aleperno/labotpfinal/README.md

labotpfinal
===========

Archivos para el proyecto final de la materia Laboratorio (66.01) de la Facultad de Ingenieria (UBA)
