aleperno/labotpfinal/informe.pdf

## U.B.A. FACULTAD DE INGENIERÍA

## Departamento de Electrónica

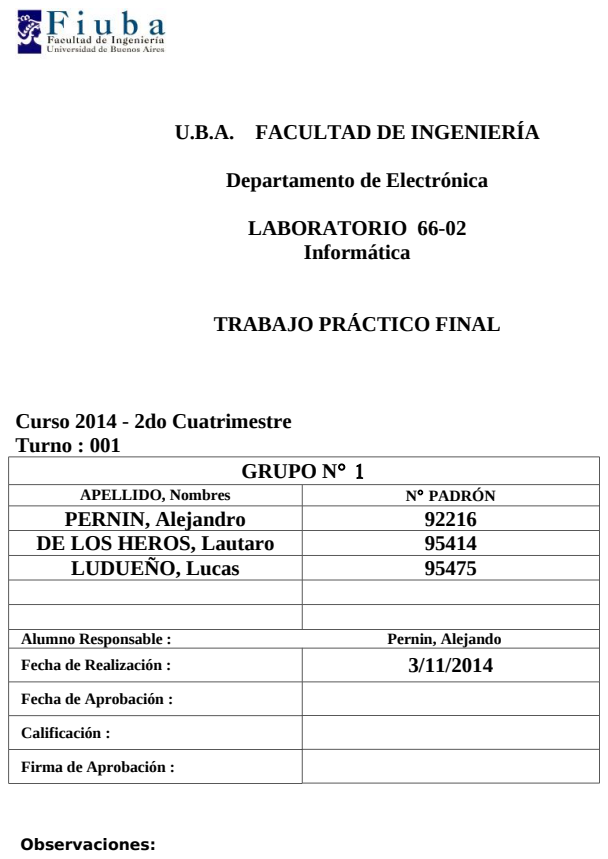
[picture p19: page 1]
LABORATORIO 66-02 Informática; Curso 2014 - 2do Cuatrimestre Turno : 001; GRUPO N° 1; APELLIDO, Nombres; N° PADRÓN; PERNIN, Alejandro; DE LOS HEROS, Lautaro; LUDUEÑO, Lucas; Alumno Responsable :; Pernin, Alejando; Fecha de Realización :; Calificación :; Observaciones:

TRABAJO PRÁCTICO FINAL

Fecha de Aprobación :

Firma de Aprobación :

# TP Final

### Grupo 1

### 20 de noviembre de 2014

Facultad de Ingenieria | Laboratorio - 66.02 - Curso 001 - TP Final

## Índice

1. Introducción | 4
2. Circuito Esquemático | 5
3. Diagrama de bloques | 5
4. Desarrollo | 6
5. Escalabilidad | 16
6. Referencias | 18

## 1. Introducción

El objetivo de este informe es exponer el trabajo práctico final, mostrando los desarrollos, mediciones efectuadas, funcionamiento y decisiones tomadas durante la confección del mismo. Este fue realizado a lo largo del cuatrimestre en paralelo con las clases prácticas y los ´ otros trabajos prácticos. Todos los archivo aquí utilizados, incluyendo este informe y su fuente estarán disponibles en http://github.com/aleperno/labotpfinal. Adicionalmente habrán disponibles algunos videos en YouTube con filmaciones de determinadas mediciones, por lo que es recomendable tener este informe en formato digital para fácil acceso a dichos links.

### 1.1. Opciones Disponibles

Habiendo diversas alternativas de proyectos de TPs para elegir, en un principio no estuvo del todo claro cuál elegir ya que todos tenian sus complicaciones y objetivos. Algunas de las alternativas disponibles eran la confección de una fuente, un sensor, etc.

### 1.2. Opción Elegida

Como proyecto base decidimos desarrollar un voltímetro vúmetro disponible en los cursos de CEKIT 1
. Elegimos este proyecto ya que si bien se trata de un proyecto relativamente sencillo, tiene aplicaciones reales tanto industriales como hogareñas.
Además aprovechando que uno de los integrantes poseía un Arduino 2 y una Raspberry 3 decidimos como opcional escalar el proyecto utilizando dichos elementos. En el informe se desarrollará el proyecto base y el opcional se detallará en la sección 5 de escalabilidad del proyecto.
El vúmetro consiste en un arreglo de LEDs que se van encendiendo conforme aumenta la tensión mensurada, la relación entre la cantidad de LEDs encendidos y la tensión proviene de las características intrínsecas del circuito cuyo análisis es parte de este informe. En este proyecto no sólo se implementan las nociones aprendidas tanto en las clases teóricas como en los TPs realizados, sino que además se emplearon nociones de diseño y elaboración de circuitos y software; por lo que es válido decir que este es un proyecto integrador.

1Pdf del proyecto oringal https://github.com/aleperno/labotpfinal/raw/master/cekit.pdf2http://arduino.cc/
3http://www.raspberrypi.org/

## 2. Circuito Esquemático

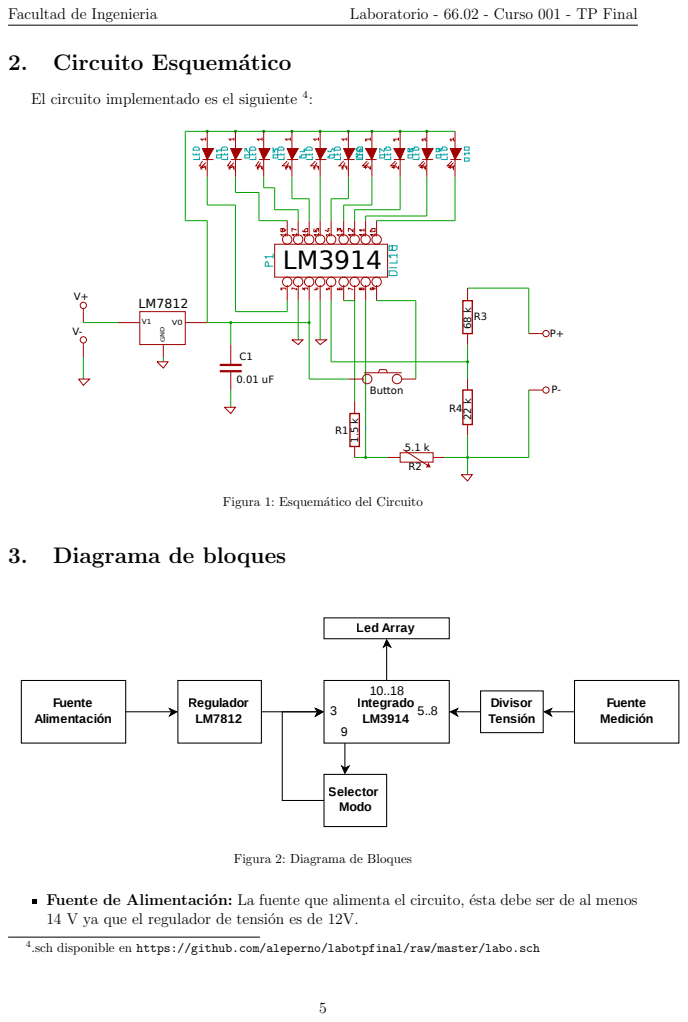
[picture p20: page 5]
GND; Button; Fuente Alimentación; Regulador LM7812; Integrado LM3914 3; Selector Modo; Fuente Medición; Divisor Tensión; Led Array

El circuito implementado es el siguiente 4

Figura 1: Esquemático del Circuito

3. Diagrama de bloques

Figura 2: Diagrama de Bloques

Fuente de Alimentación: La fuente que alimenta el circuito, ésta debe ser de al menos
14 V ya que el regulador de tensión es de 12V.

.sch disponible en https://github.com/aleperno/labotpfinal/raw/master/labo.sch

Regulador de Tensión: El regulador cumple la función de mantener el equipo alimen-tado con 12 V, evitando daños si la entrada es mayor.

Selector Modo: Nos permite seleccionar ambos modos de funcionamiento del circuito, tanto en ”DOT”(se prende un sólo LED), como ”BAR”(Se prende consecutivamente el array).

Fuente Medición: Es la fuente de tensión a mensurar.

Divisor de Tensión: Siendo que el integrado posee un límite de 5 V de entrada a medir, se coloca un divisor de tensión para ajustar la tensión a las especificaciones.

Array de LEDs: Es el arreglo de LEDs luminosos en si, en este caso consiste de 10 LEDs.

Integrado LM3914: Es el integrado encargado de la lógica del circuito.

## 4. Desarrollo

Como primera instancia se debió analizar cuales serían los alcances del proyecto y ajustar las características del circuito al mismo. Lo principal a definir fue el rango de tensiones que mediriámos, decidimos utilizar el mismo rango utilizado como ejemplo en el proyecto orignal, comprendido entre los 0 y 25 V.
Acorde al datasheet del integrado 5
el resistor R1 es el encargado de regular la luminosidad de los LED. Asimismo se establece como corrientes de salida hacia los LED de un mínimo de 7 mA y un típico de 10 mA, para el proyecto establecimos un valor intermedio en 8,3 mA. Siendo la tensión interna de referencia de 1,25 V, por la ley de Ohm podemos calcular

R1 =

1,25 V ∗ 10 LED
8,3 mA
∼= 1,5 kΩ | (1)

Luego es preciso establecer un fondo de escala, la misma se calcula acorde la siguiente fórmula:

Vref = 1,25 V (1 + R2
R1
) | (2)

Siendo la máxima señal de entrada permitida de 5 V, para poder mensurar el rango antes mencionado (0 - 25 V) debemos emplear un divisor de tensión, para tal propósito se emplearon los resistores R3 = 68 kΩ y R4 = 22 kΩ. Acorde a estos valores, aplicando una tensión de 25 V, sobre R4 se obtendrá una caída de tensión equivalente a

∆VR4 =

25 V ∗ 22 kΩ
90 kΩ
∼= 6,1 V | (3)

Si consideramos la tensión máxima de referencia, según la ecuacion 2:

R2 =

Vref
1,25 V

− 1

∗ R1
Vref =5 V
= 4,5 kΩ | (4)

Siendo este resistor de un valor no comercial y con el fin de a posteriori poder realizar ajustes, empleamos un resistor variable de 10 kΩ. Teniendo todos los elementos principales ya descriptos, se prosiguió al diseño y confección del circuito.

5Ver sección 6.

### 4.1. Construcción

Como primer instancia luego de adquirir todos los elementos, se armó el circuito en un protoboard a fin de corroborar el funcionamiento de todos los componentes individual y con-juntamente.

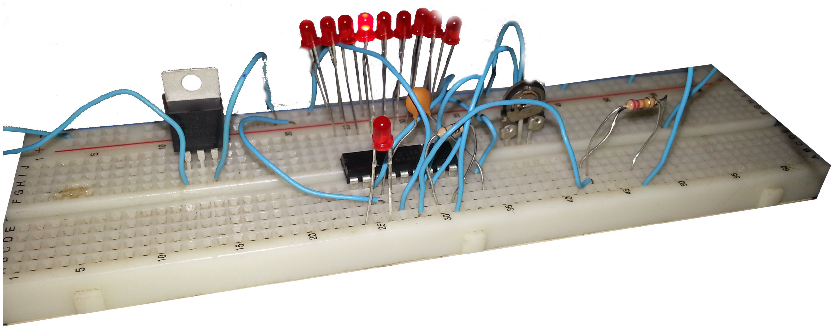
[picture p21: figure]

Figura 3: Prototipo modo DOT

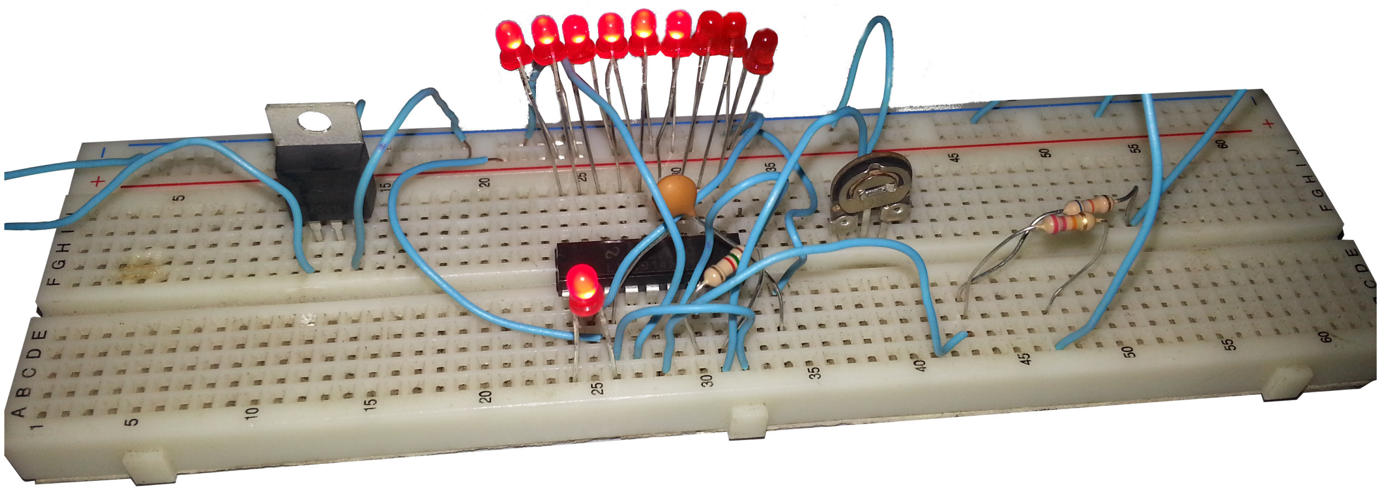
[picture p22: figure]

Figura 4: Prototipo modo BAR

Luego aprovechando la disponibilidad de un archivo esquemático, utilizando herramientas informáticas se diseñó un circuito virtual que luego sería pasado a una plaqueta de cobre.

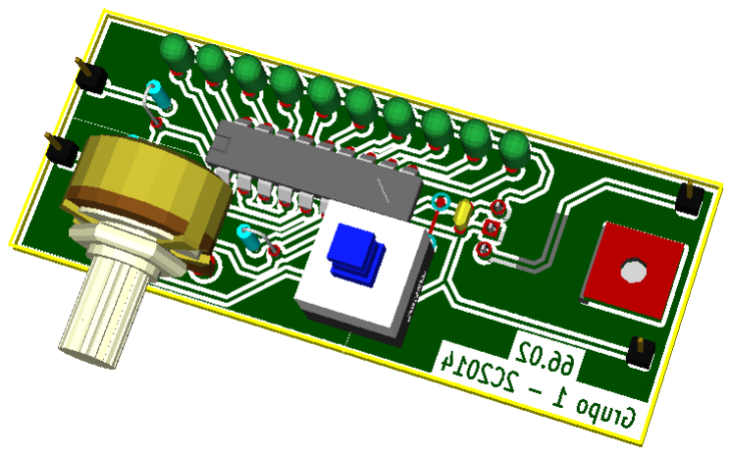
[picture p23: figure]

Figura 5: Vista Superior Circuito Virtual

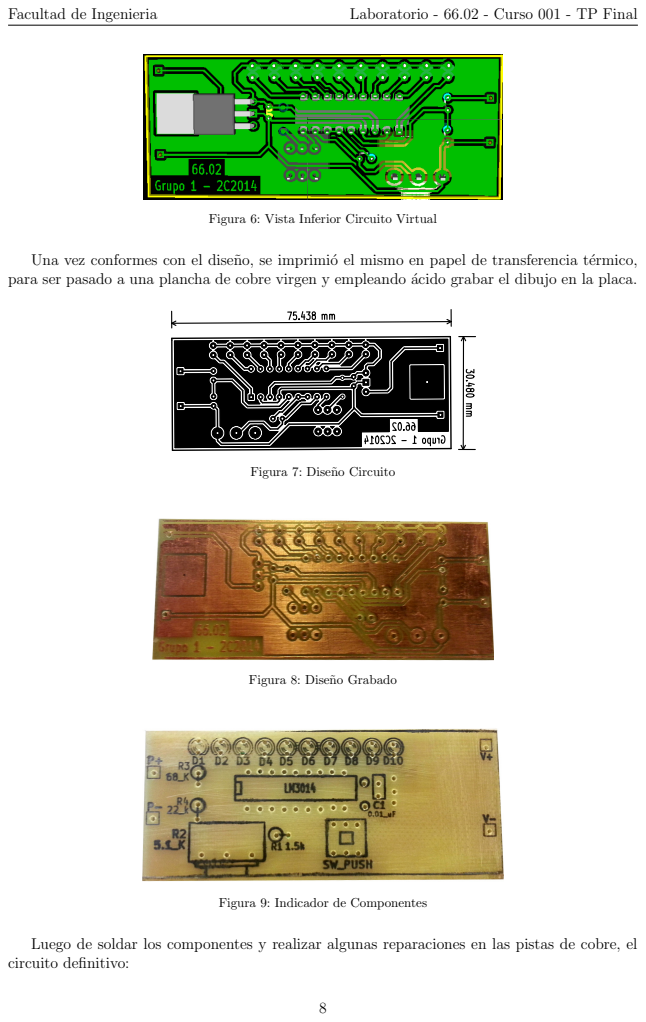
[picture p24: page 8]

Figura 6: Vista Inferior Circuito Virtual

Una vez conformes con el diseño, se imprimió el mismo en papel de transferencia térmico,
para ser pasado a una plancha de cobre virgen y empleando ácido grabar el dibujo en la placa.

Figura 7: Diseño Circuito

Figura 8: Diseño Grabado

Figura 9: Indicador de Componentes

Luego de soldar los componentes y realizar algunas reparaciones en las pistas de cobre, el
circuito definitivo:

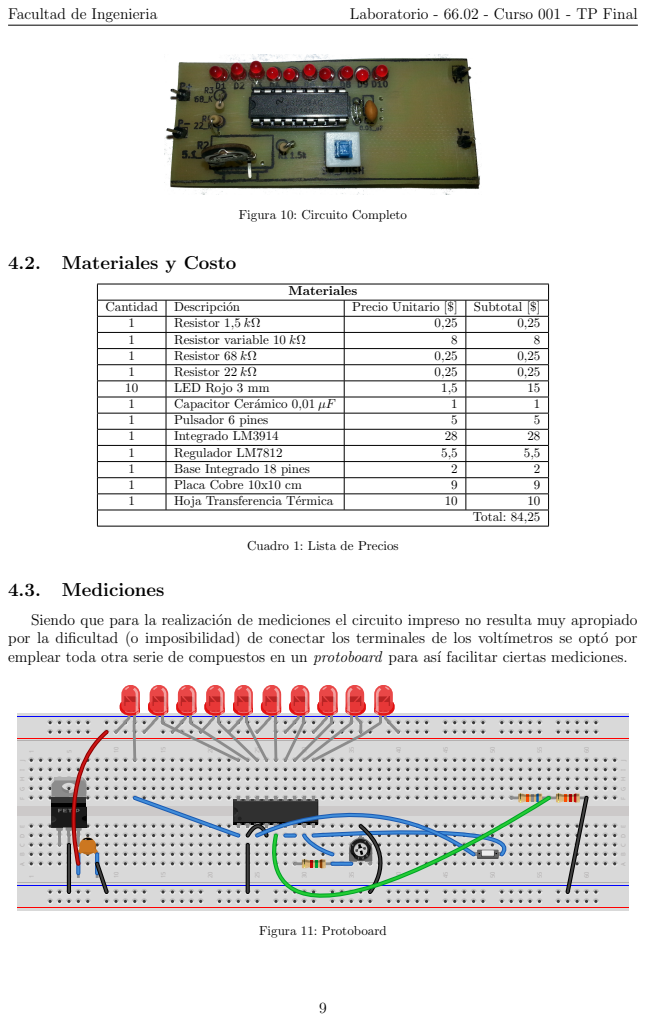
[picture p25: page 9]
4.2. Materiales y Costo; Materiales; Total: 84,25; 4.3. Mediciones; Figura 11: Protoboard

Figura 10: Circuito Completo

Cantidad | Descripción | Precio Unitario [$] | Subtotal [$]
1 | Resistor 1,5 kΩ | 0,25 | 0,25
1 | Resistor variable 10 kΩ | 8 | 8
1 | Resistor 68 kΩ | 0,25 | 0,25
1 | Resistor 22 kΩ | 0,25 | 0,25
10 | LED Rojo 3 mm | 1,5 | 15
1 | Capacitor Cerámico 0,01 µF | 1 | 1
1 | Pulsador 6 pines | 5 | 5
1 | Integrado LM3914 | 28 | 28
1 | Regulador LM7812 | 5,5 | 5,5
1 | Base Integrado 18 pines | 2 | 2
1 | Placa Cobre 10x10 cm | 9 | 9
1 | Hoja Transferencia Térmica | 10 | 10

Cuadro 1: Lista de Precios

Siendo que para la realización de mediciones el circuito impreso no resulta muy apropiado
por la dificultad (o imposibilidad) de conectar los terminales de los voltímetros se optó por
emplear toda otra serie de compuestos en un protoboard para así facilitar ciertas mediciones.

Para todas las mediciones a realizar se empleará el multímetro digital MS8221A utilizado en los trabajos anteriores, en caso de emplearse otro se aclarará explícitamente. Asímismo las fuentes reguladas a utilizar serán las HY3005D empleadas con anterioridad, para el funcionamiento de este proyecto se emplearán dos, una como alimentación del circuito y otra como fuente a mensurar.

### 4.3.1. Regulador

Uno de los componentes claves del circuito es el regulador de tensión LM7812, el cual se emplea con el propósito de obtener una salida constante de 12 V. Como primera medición se mide la salida del regulador respecto de la entrada de tensión. Se espera que a bajos voltajes la tensión de salida sea similar a la tensión de entrada pero menor. Además se espera que la tensión para la cual la salida se estabiliza, este uno o dos voltios por encima de los 12 V. Empleando un simple banco de medición con una fuente y un voltímetro se obtuvieron los

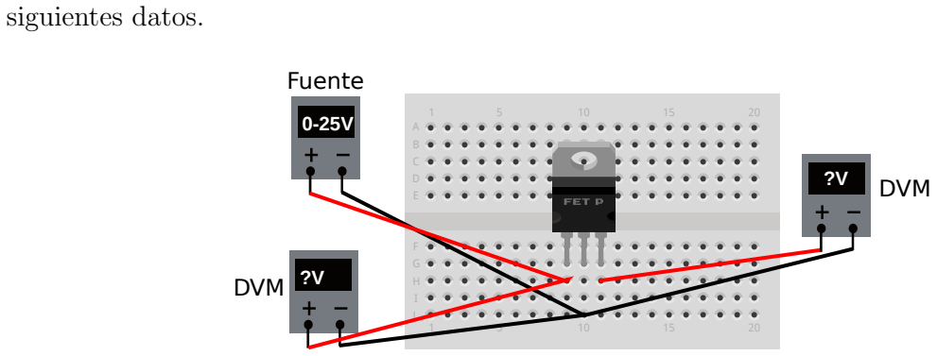
[picture p26: figure]
siguientes datos.; DVM; Fuente

Figura 12: Banco de Medición Regulador de Tensión

Regulador Tensión

Vin | ∆Vin | Vout | ∆Vout
1,62 | 0,02 | 0,97 | 0,02
3,24 | 0,03 | 2,55 | 0,02
4,96 | 0,04 | 4,2 | 0,04
7,56 | 0,05 | 6,75 | 0,05
10,34 | 0,07 | 9,5 | 0,05
12,44 | 0,08 | 11,58 | 0,07
12,76 | 0,08 | 11,91 | 0,07
13 | 0,08 | 12,14 | 0,08
13,13 | 0,08 | 12,2 | 0,08
13,37 | 0,08 | 12,21 | 0,08
14,36 | 0,09 | 12,21 | 0,08
15,75 | 0,09 | 12,21 | 0,08
17,38 | 0,10 | 12,22 | 0,08
20,1 | 0,3 | 12,21 | 0,08
22,4 | 0,3 | 12,21 | 0,08
24,5 | 0,3 | 12,21 | 0,08
28,1 | 0,3 | 12,22 | 0,08
31,4 | 0,3 | 12,25 | 0,08

Cuadro 2: Medición LM7812

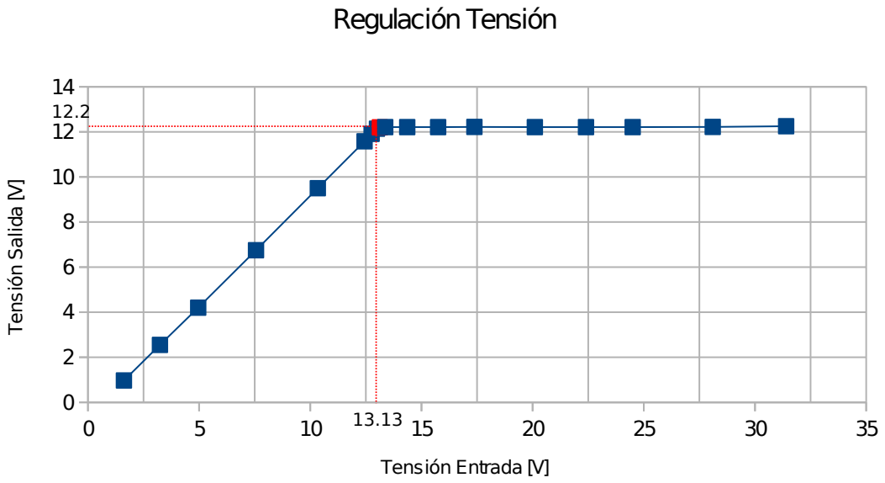
[picture p27: figure]
Regulación Tensión; Tensión Entrada [V]; Tensión Salida [V]

Figura 13: Tensión Salida Regulador

Como era de esperarse, la tensión de salida es lineal e inferior a la tensión de entrada a tensiones bajas. También confirmamos que el punto en el cuál la tensión de salida se estabiliza (13.13 V) se encuentra por encima de la tensión de regulación. La figura ?? no posee barras de errores ya que como se puede apreciar en el cuadro 2 los errores son despreciables respectos de los valores que operamos.

### 4.3.2. Escala

Acorde a las hipótesis realizadas, el vúmero posee un fondo de escala de 25 V distribuidos en 10 LEDs, por lo que cada LED representará un aumento en la tensión de 2,5 V.

Escala LEDs
#Led Encendido(s) | Tensión [V]

0 | < 2,5
1 | 2,5
2 | 5
3 | 7,5
4 | 10
5 | 12,5
6 | 15
7 | 17,5
8 | 20
9 | 22,5
10 | 25

Cuadro 3: Escala leds

Para corrobororar esta escala y/o realizar los ajustes necesarios se emplearon dos fuentes reguladas, una como fuente de alimentación del circuito y otra como fuente a mensurar. Asimismo en paralelo con la fuente a mensurar se coloca un multímetro digital a fin de tener una lectura mas exacta de la tensión respecto de la mostrada por la pantalla LED de la fuente.

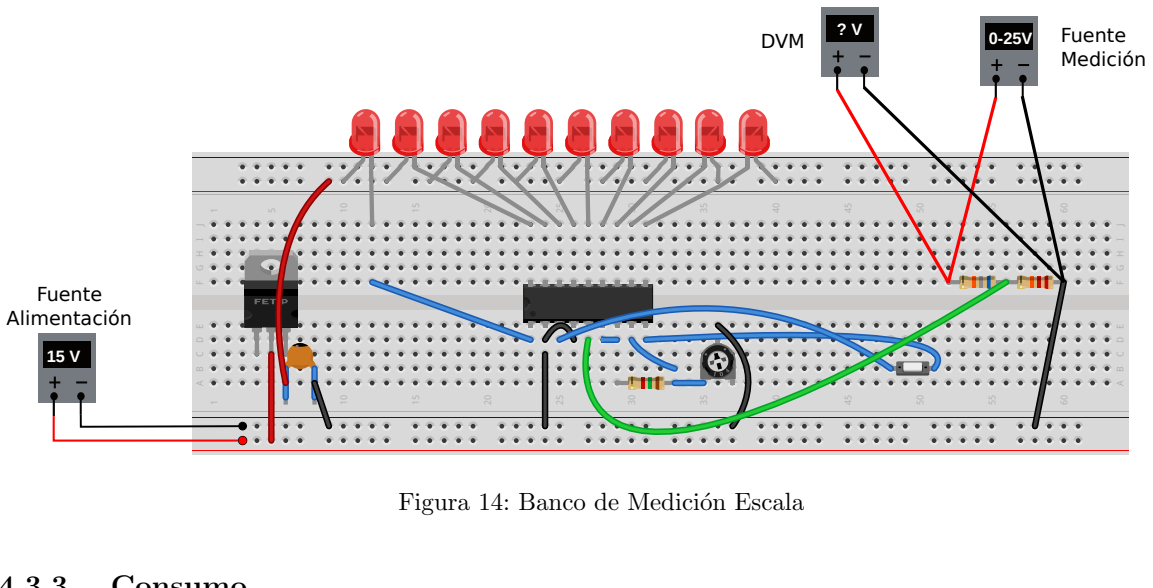
[picture p28: figure]
Fuente Alimentación; Fuente; Medición; ? V DVM; Figura 14: Banco de Medición Escala

### 4.3.3. Consumo

Una de las principales características de este circuito, es la capacidad de cambiar entre modo BAR y modo DOT, obteniendo así una misma lectura expresada en un sólo led o en un continuo de leds. A priori se puede deducir que entre ambos modos habrá una diferencia de consumo proveniente de tener un sólo led o un número de leds. Asímismo se espera que en modo punto el consumo sea lineal, para ello se fue variando la tensión de la fuente a mensurar y se midió la corriente. Con dichos valores se calculó la potencia.

Mediciones DOT
Tensión [V] | ∆V [V] | Corriente [mA] | ∆I [mA] | Consumo [mW] | ∆ Consumo [mW]
0,40 | 0,02 | 10,2 | 0,3 | 4,1 | 0,3
1,29 | 0,02 | 10,2 | 0,3 | 13,2 | 0,5
2,50 | 0,03 | 24,3 | 0,4 | 60,8 | 1,6
3,82 | 0,03 | 24,4 | 0,4 | 93,2 | 2,3
5,08 | 0,04 | 24,3 | 0,4 | 123,4 | 2,9
6,78 | 0,05 | 24,3 | 0,4 | 164,8 | 3,8
7,50 | 0,05 | 23,7 | 0,4 | 177,8 | 4,1
8,85 | 0,06 | 23,8 | 0,4 | 210,6 | 4,8
10,61 | 0,07 | 24,5 | 0,4 | 259,9 | 5,8
11,83 | 0,07 | 24,4 | 0,4 | 288,7 | 6,4
12,64 | 0,08 | 24,4 | 0,4 | 308,4 | 6,8
13,81 | 0,08 | 24,4 | 0,4 | 337,0 | 7,4
15,08 | 0,09 | 24,1 | 0,4 | 363,4 | 8,0
16,75 | 0,1 | 24,1 | 0,4 | 403,7 | 8,8
17,63 | 0,1 | 24,0 | 0,4 | 423,1 | 9,2
18,75 | 0,1 | 24,0 | 0,4 | 450,0 | 9,8
20,0 | 0,2 | 23,7 | 0,4 | 474,0 | 10,3
21,3 | 0,2 | 23,7 | 0,4 | 504,8 | 11,0
22,5 | 0,2 | 23,9 | 0,4 | 537,8 | 11,7
23,7 | 0,2 | 23,9 | 0,4 | 566,4 | 12,3
25,0 | 0,2 | 24,0 | 0,4 | 600,0 | 13,0
26,4 | 0,2 | 24,0 | 0,4 | 633,6 | 13,7

Cuadro 4: Medición Consumo modo DOT

Mediciones BAR
Tensión [V] | ∆V [V] | Corriente [mA] | ∆I [mA] | Consumo [mW] | ∆ Consumo [mW]
0,40 | 0,02 | 10,3 | 0,3 | 4,1 | 0,3
1,29 | 0,02 | 10,3 | 0,3 | 13,3 | 0,5
2,50 | 0,03 | 24,5 | 0,4 | 61,3 | 1,6
3,82 | 0,03 | 24,5 | 0,4 | 93,6 | 2,3
5,08 | 0,04 | 38,5 | 0,6 | 195,6 | 4,3
6,78 | 0,05 | 38,5 | 0,6 | 261,0 | 5,6
7,50 | 0,05 | 51,8 | 0,8 | 388,5 | 7,9
8,85 | 0,06 | 51,8 | 0,8 | 458,4 | 9,2
10,61 | 0,07 | 65,7 | 0,9 | 697,1 | 13,6
11,83 | 0,07 | 65,7 | 0,9 | 777,2 | 15,1
12,64 | 0,08 | 79,6 | 1,1 | 1006,1 | 19,2
13,81 | 0,08 | 79,6 | 1,1 | 1099,3 | 20,9
15,08 | 0,09 | 93,4 | 1,3 | 1408,5 | 26,4
16,75 | 0,1 | 93,4 | 1,3 | 1564,5 | 29,3
17,63 | 0,1 | 107,3 | 1,4 | 1891,7 | 35,0
18,75 | 0,1 | 107,3 | 1,4 | 2011,9 | 37,2
20,0 | 0,2 | 120,4 | 1,6 | 2408,0 | 44,2
21,3 | 0,2 | 120,5 | 1,6 | 2566,7 | 47,0
22,5 | 0,2 | 133,0 | 1,7 | 2992,5 | 54,5
23,7 | 0,2 | 133,1 | 1,7 | 3154,5 | 57,4
25,0 | 0,2 | 145,0 | 1,9 | 3625,0 | 65,6
26,4 | 0,2 | 145,2 | 1,9 | 3833,3 | 69,3

Cuadro 5: Medición Consumo modo BAR

Con toda esta información disponible, es posile comparar mediante gráficos y confirmar algunas deducciones.

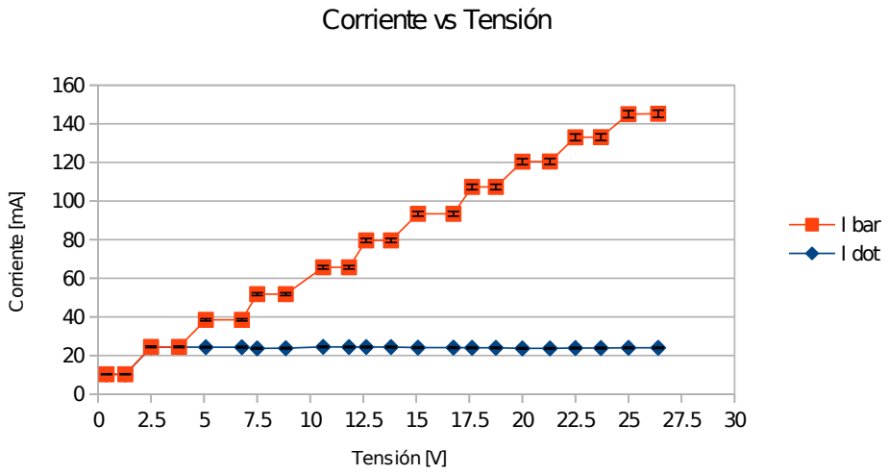
[picture p29: figure]
Corriente vs Tensión; I bar I dot; Tensión [V]; Corriente [mA]

0 | 2.5 | 5 | 7.5 10 12.5 15 17.5 20 22.5 25 27.5 30

Figura 15: Corriente vs Tensión

Como era de esperarse, la corriente en modo punto es constante observándose sólo un salto siendo que antes de los 2,5 V no se encuentra ningun led encendido. Asimismo se observa que en modo bar la corriente es lineal, habiendo unos descansos correspondientes a tensiones dentro del rango de un mismo led.
Una interrogante que se puede desprender de este gráfico es si dichos saltos son constantes.

### Salto Corriente

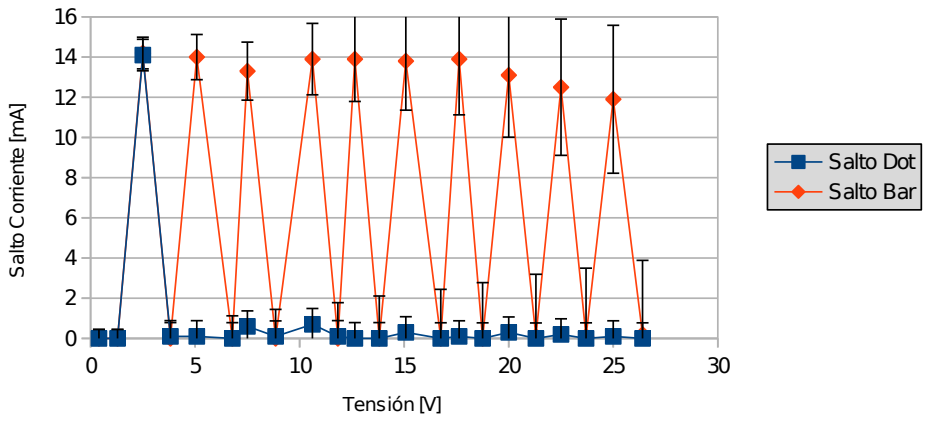
[picture p30: figure]
Salto Dot Salto Bar; Tensión [V]; Salto Corriente [mA]

Figura 16: Saltos Corriente

Estos saltos corresponden al valor de una corriente respecto de la corriente antes mensurada. Otra vez es observable como en modo punto sólo hay un salto y luego los saltos se encuentran muy próximos a 0. Para el modo bar, se observa una oscilacion correspondiente a que los puntos dentro del mismo rango de tension de un led (eg: 2,6 V y 3.0 V encienden el mismo led) no hay salto de corriente significativo, pero al encender un nuevo led si. Asimismo es visible como los valores pico de estos saltos se mantienen dentro de un rango discreto.

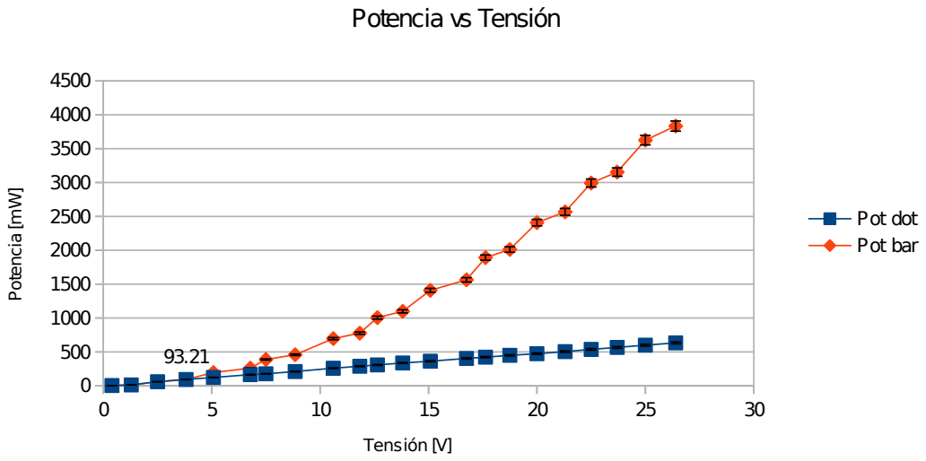
[picture p31: figure]
Potencia vs Tensión; Pot dot Pot bar; Tensión [V]; Potencia [mW]

Figura 17: Potencia

Es observable como la potencia disipada por el circuito en modo BAR no sólo es mayor al de modo DOT punto a punto, sino también como la curva de crecimiento de la misma tiene a una forma exponencial. Esto tiene sentido ya que considerando la potencia como

P = V ∗ I | (5)

donde P, V e I son la potencia, tensión y corriente respectivamente; de ser la corriente constante la potencia describirá una curva lineal tal cual indica la figura 17 para el modo DOT. En el caso del modo BAR, la corriente incrementa linealmente respecto de la tensión (ver figura 15) pudiéndola expresar como I = αV , siendo α una constante de proporción. Aplicando esto a la ecuación arriba descripta

P = V ∗ I = V ∗ αV = αV ²
(6)

lo que valida que la curva describa una trayectoria exponencial.

## 5. Escalabilidad

Pensando en las aplicaciones prácticas de un voltímetro, nos encontramos con la necesidad de poder obtener una lectura exacta y/o a distancia. Un vúmetro si bien es de lectura sencilla, no nos da un valor númerico ni tampoco nos permite leer la lectura a distancia. Si pensamos esto a nivel industrial es una gran desventaja, quizá por cuestiones de la complejidad de un determinado proceso es preciso obtener una lectura exacta; asimismo las extensiones de las plantas industriales obligan a realizar mediciones mediante sensores que reporten a una base central, para consultarlas en un centro de control.
Abstrayendonos del caso insdustrial planteado y aprovechando que un compañero poseía un Arduino y Raspberry, decidimos implementar un voltímetro que muestre en una pantalla LED la tensión mensurada y asímismo permita una lectura a distancia. Para ello utilizamos un Arduino Mega 2560 R3 6

con un shield LCD DFRobot⁷ y una Raspberry Pi B+ 8 .
En nuestro caso el Arduino actuará como sensor, que no sólo tomará las mediciones sino que las mostrará en una pantalla LCD sino que también las comunicará a la Raspberry por puerto serie. La Raspberry representará un sistema central de obtención de mediciones, en la misma se instaló un servidor web Apache y una simple página en PHP que muestra vía web las tensiones mensuradas en tiempo real. Además esta configuración nos permitiría registrar un historial de las mediciones realizadas para posterior análisis.
Utilizando el mismo rango de tensiones utilizado con el vúmetro y siendo la máxima tensión permitida por el Arduino de 5 V es necesario utilizar un resistor de tensión, para lo cuál se utilizaron resistores de 100 Ω y 1 kΩ.

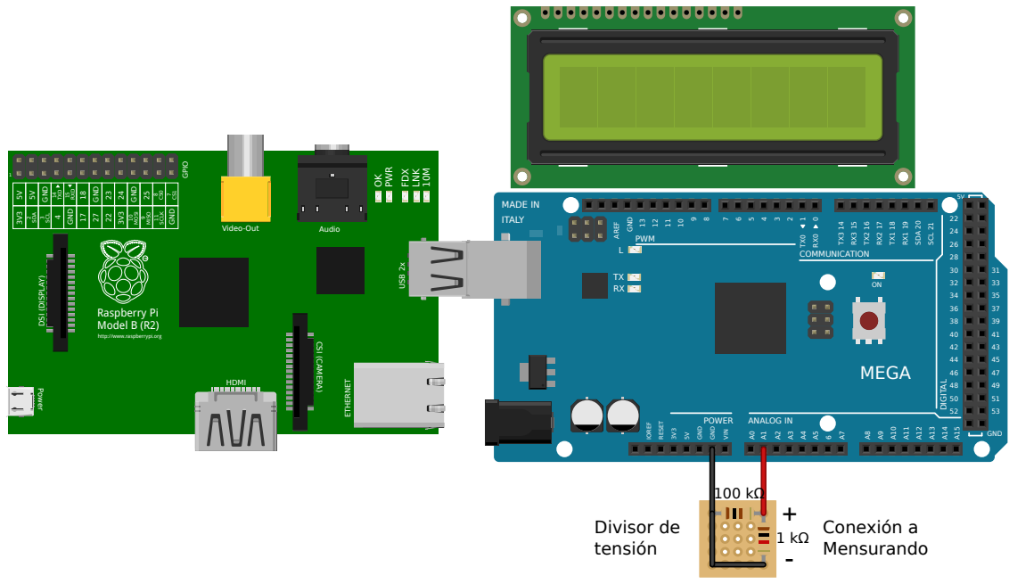
[picture p32: figure]
ANALOG IN; COMMUNICATION; POWER; AREF; GND; RESET; VIN; SDA 20; SCL 21; MADE IN; ITALY; PWM; DIGITAL; MEGA; IOREF; Raspberry Pi Model B (R2); http://www.raspberrypi.org; PWR; FDX; LNK; Power; HDMI; Video-Out; Audio; USB 2x; ETHERNET; DSI (DISPLAY); CSI (CAMERA); GPIO; 27 GND; MOSI; SDA; SCL; MISO; SCLK; TXD; RXD; + Conexión a; Mensurando; Divisor de; tensión

Figura 18: Banco Medición Arduino - Raspberry

Mediante un software compilado y cargado previamente, el Arduino mide la tensión aplicada al puerto analógico indicado (en este caso A1), calcula la tensión de la fuente mensurada

6http://arduino.cc/en/Main/arduinoBoardMega7http://www.dfrobot.com/wiki/index.php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 8http://www.raspberrypi.org/products/model-b-plus/

teniendo en cuenta las características del resistor de tensión e imprime en el LCD el valor además de transmitirlo por puerto serie (emulado por USB).

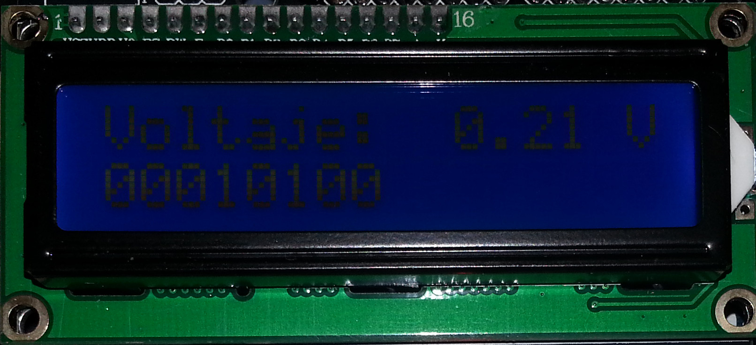
[picture p33: figure]

Figura 19: Prueba LCD

## 6. Referencias
