aleperno/labotpfinal/attachments/dvm_specs.pdf

### 3.2.1 DC VOLTAGE

Accuracy Range | Resolution | MS8221A/8221D | MS8221B/8230B
0.2V | 0.1mV | | ±0.5%±2
2V | 1mV | | ±0.5%±3
20V | 0.01V | | ±0.8%±3
200V | 0.1V
1000V | 1V | ±0.8%±2 | ±0.8%±5

±0.5%±1

- Input impedance: MS8221A/MS8221D: 10MΩ MS8221B/MS8230B: 1MΩ
- Max. input voltage: 200mV range: 250VDC or AC rms 2V - 1000V ranges: 1000VDC or 750V rms
