aleperno/labotpfinal/attachments/dvm_specs1.pdf

3.2.3 DC CURRENT
Accuracy Range | Resolution | MS8221A/8221D | MS8221B/8230B
200uA | 0.1uA | ±0.8%±1 | ±1.0%±2
2mA | 1 uA
20mA | 10 uA | | ±1.5%±2
200mA | 100uA | ±1.2%±1
10A | 10mA | ±2.0%±5 | ±3.0%±2
Overload protection: F250mA/250V fuse (10A range unfused).
Max. Input Current: mA Jack: 200mA, 10A Jack: 10A
