aleperno/labotpfinal/images/arduino7.pdf

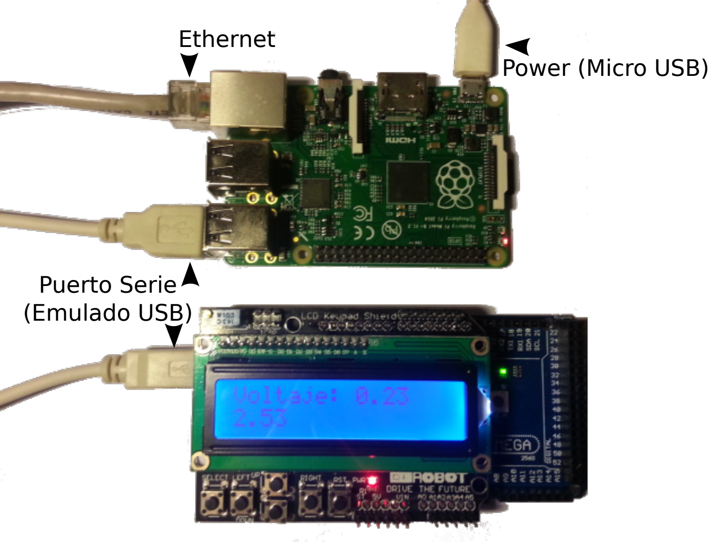
[picture p34: page 1]

Puerto Serie
(Emulado USB)

Ethernet
Power (Micro USB)
