aleperno/labotpfinal/images/bloque.pdf

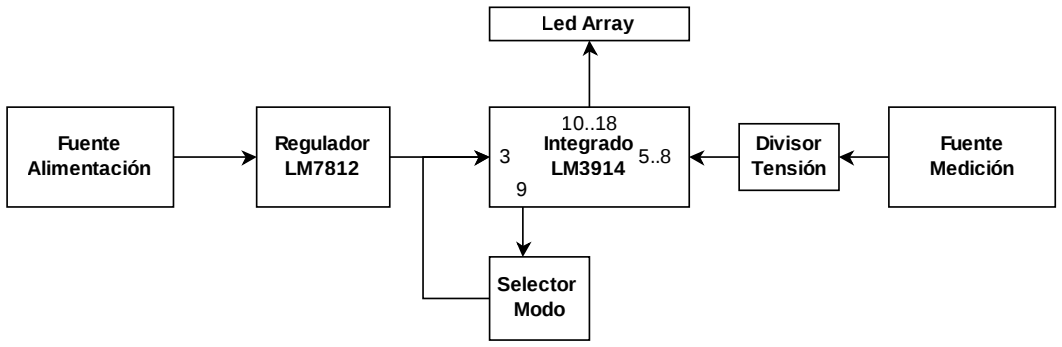
[picture p35: figure]
Fuente Alimentación; Regulador LM7812; Integrado LM3914 3; Selector Modo; Fuente Medición; Divisor Tensión; Led Array
