aleperno/labotpfinal/images/med_reg.pdf

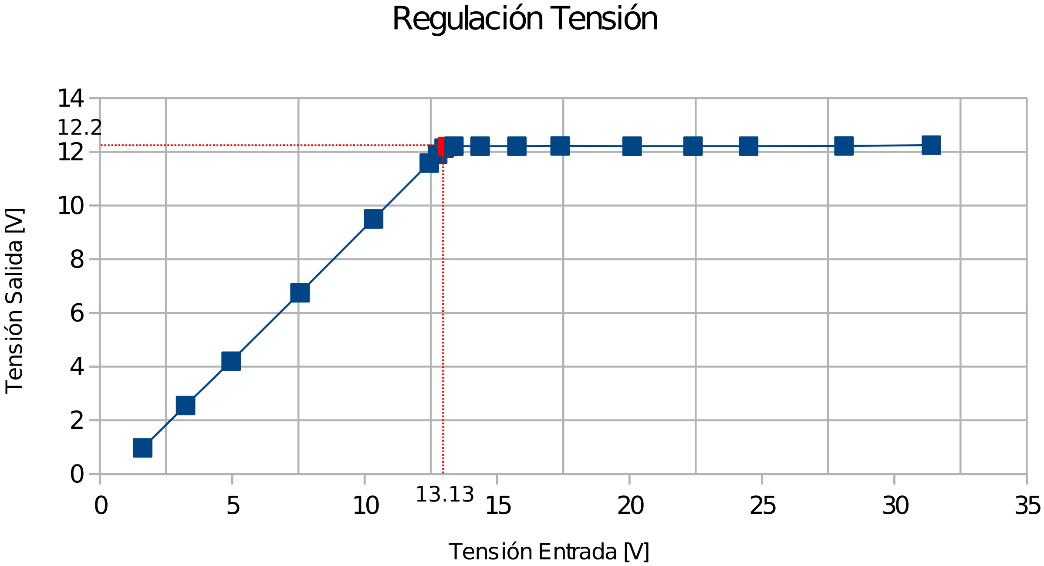
[picture p36: figure]
Regulación Tensión; Tensión Entrada [V]; Tensión Salida [V]
