aleperno/labotpfinal/images/salto.pdf

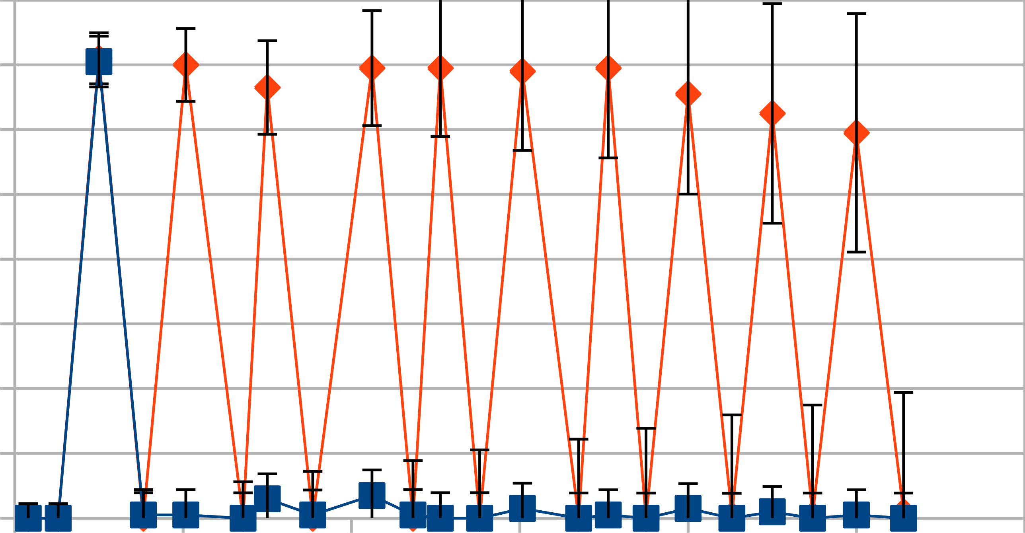
[picture p37: figure]

0 | 5 | 10 | 15 | 20 | 25 | 30

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
### Salto Corriente

Salto Dot
Salto Bar

Tensión [V]

Salto Corriente [mA]
