aleperno/labotpfinal/images/labo.png

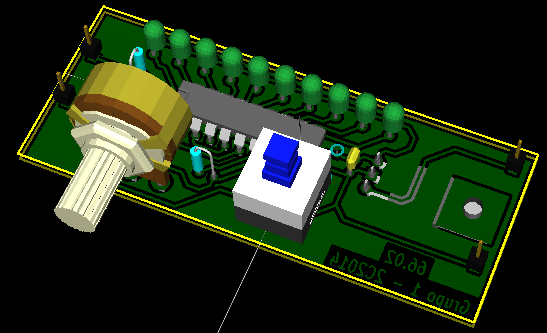
images/labo.png
