aleperno/labotpfinal/images/Cronograma.pdf

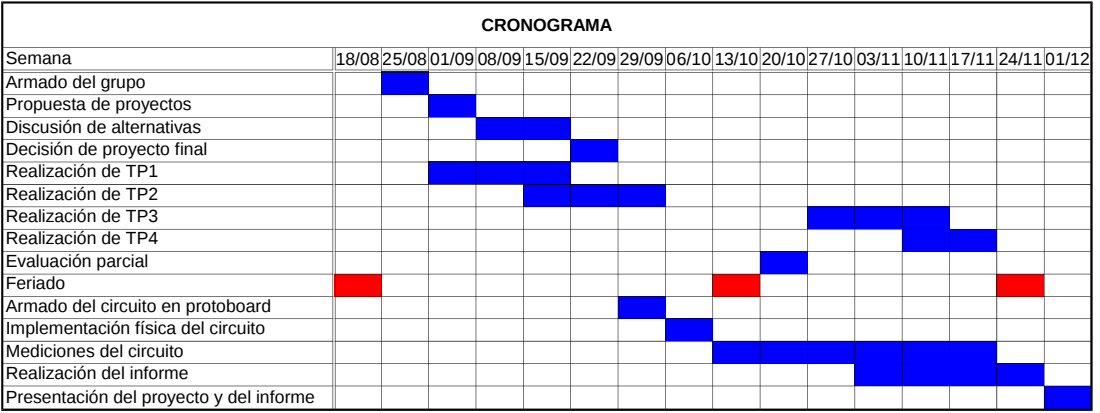
[picture p39: page 1]
CRONOGRAMA; Semana

Armado del grupo
Propuesta de proyectos
Discusión de alternativas
Decisión de proyecto final
Realización de TP1
Realización de TP2
Realización de TP3
Realización de TP4
Evaluación parcial
Feriado
Armado del circuito en protoboard
Implementación física del circuito
Mediciones del circuito
Realización del informe
Presentación del proyecto y del informe
