aleperno/labotpfinal/images/arduino3.pdf

### Lectura Arduino

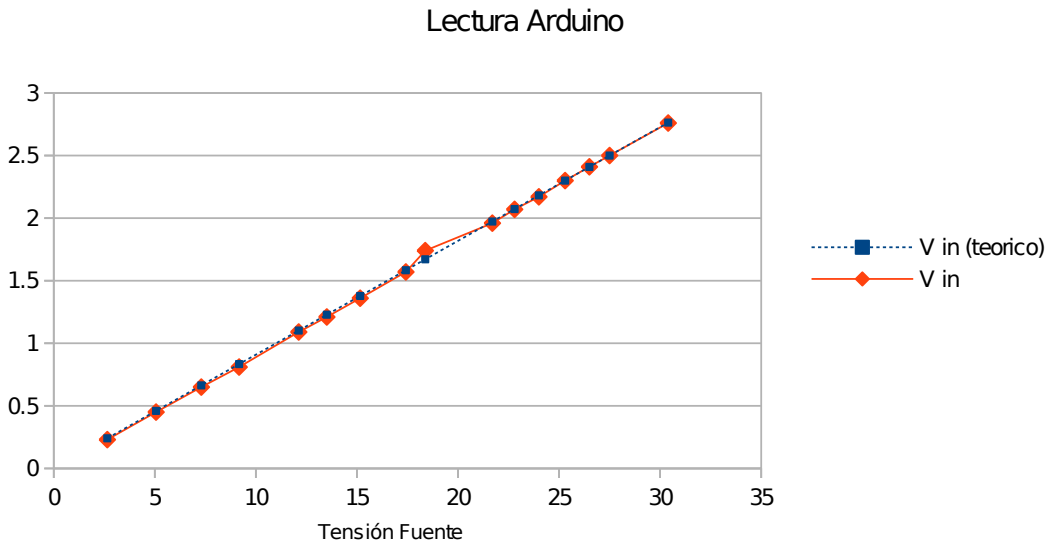
[picture p40: page 1]
V in (teorico) V in; Tensión Fuente
