aleperno/labotpfinal/images/reg.pdf

0-25V

# Fuente

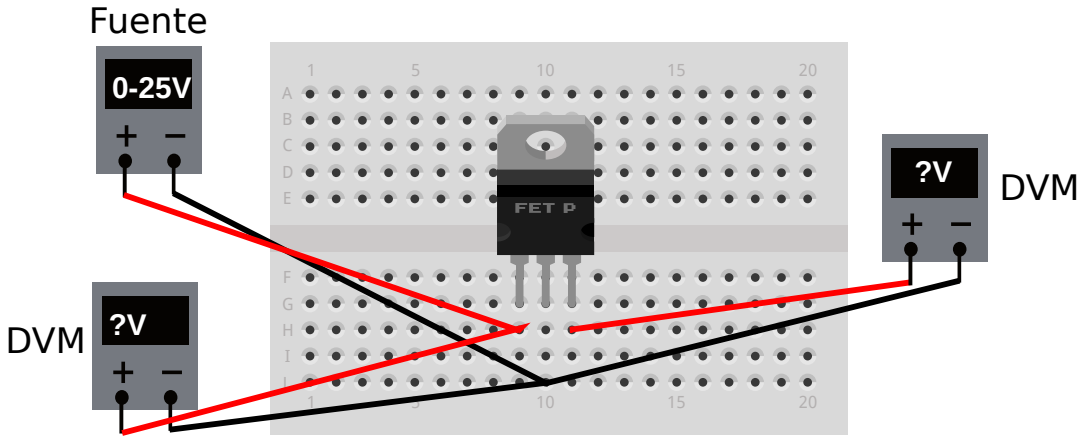
[picture p41: page 1]
ABCDEFGHIJ; DVM
