aleperno/labotpfinal/images/sch.pdf

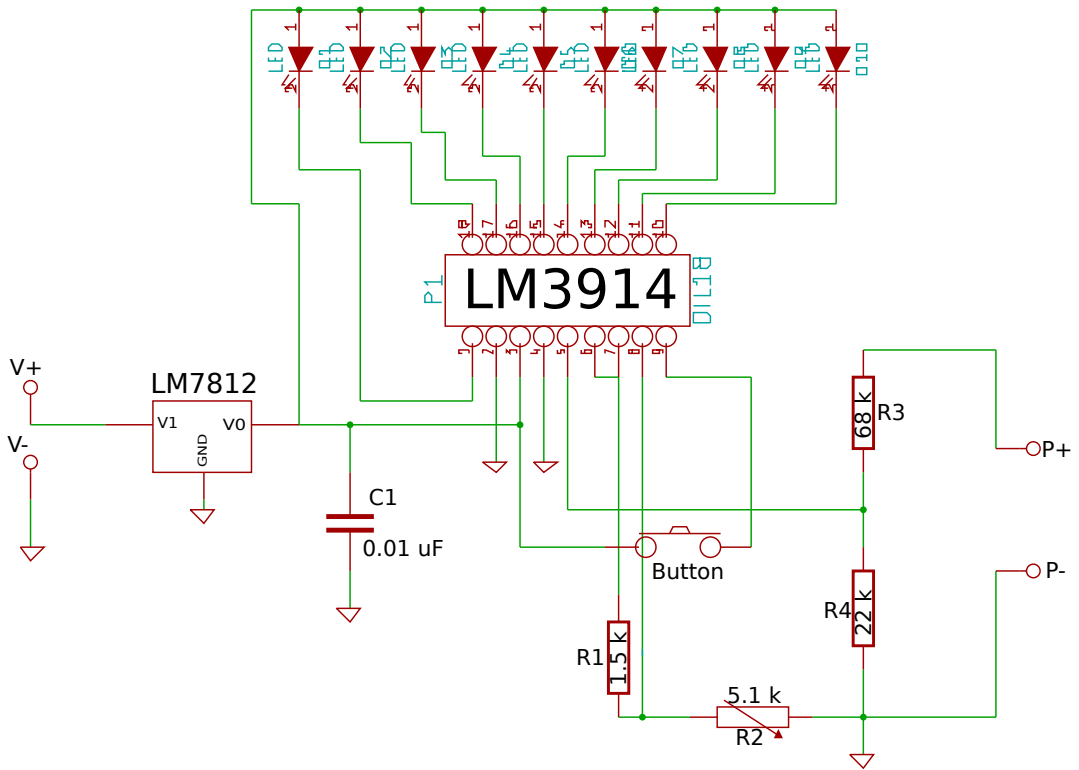
[picture p42: page 1]
GND; Button
