aleperno/labotpfinal/images/design.pdf

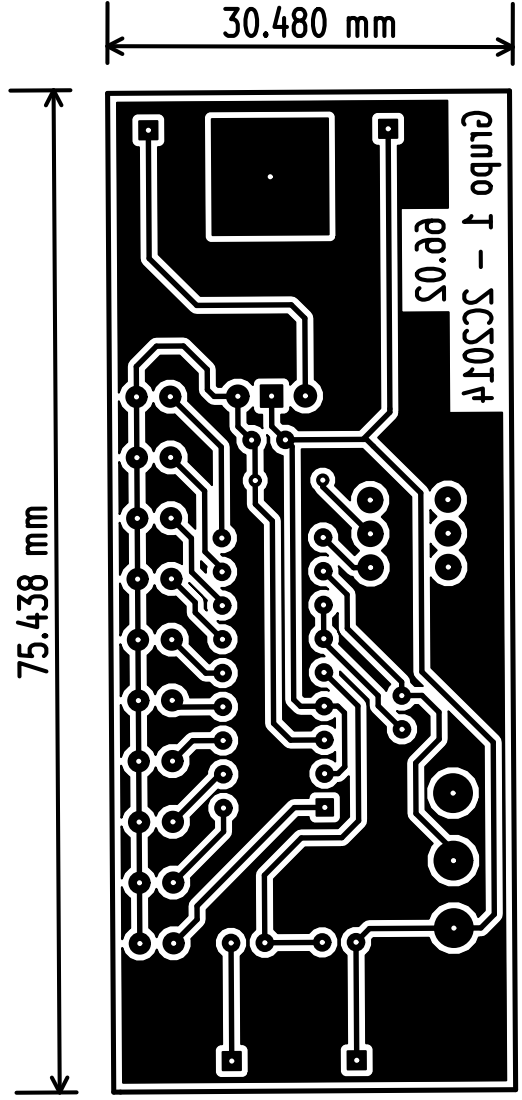
[picture p43: page 1]
