aleperno/labotpfinal/images/corriente.pdf

### Corriente vs Tensión

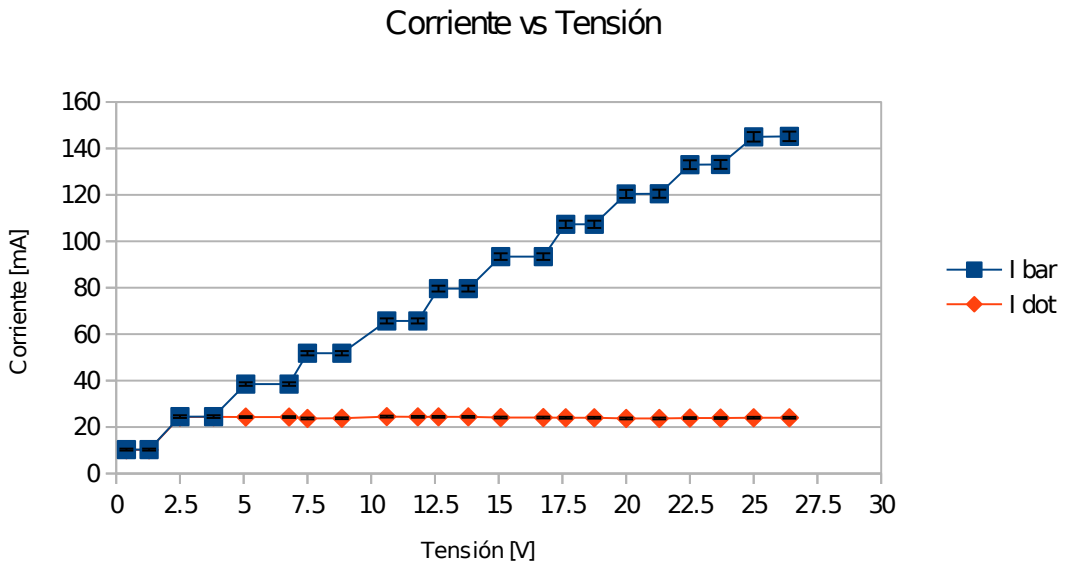
[picture p44: page 1]
I bar I dot; Tensión [V]; Corriente [mA]
