aleperno/labotpfinal/images/pot.pdf

### Potencia vs Tensión

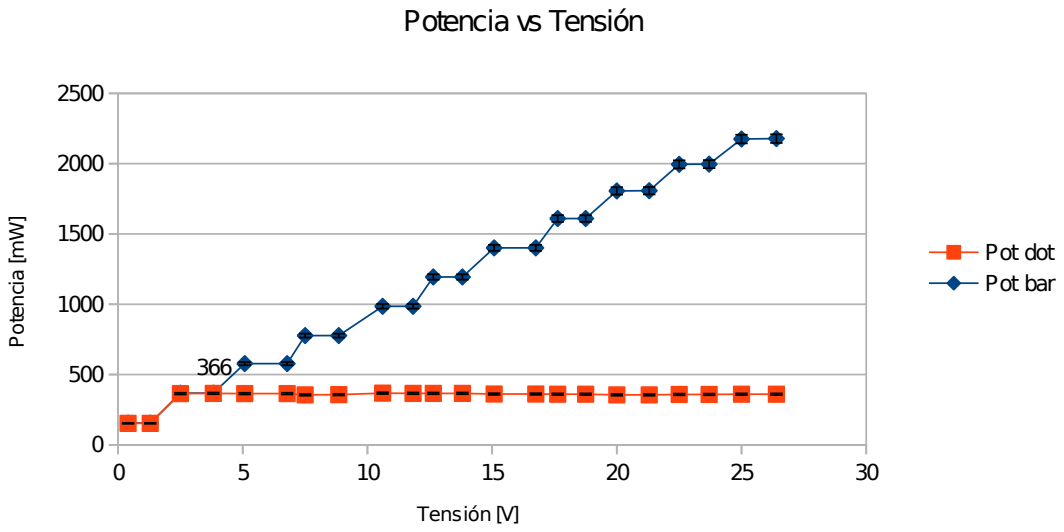
[picture p45: page 1]
Pot dot Pot bar; Tensión [V]; Potencia [mW]
