aleperno/labotpfinal/images/arduino4.pdf

### Diferencia Lectura vs Fuente

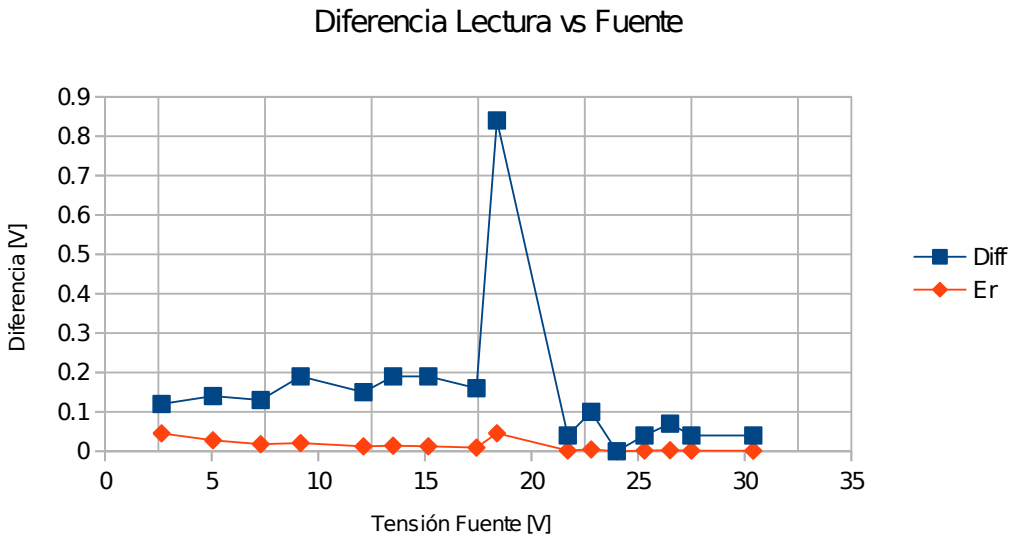
[picture p46: page 1]
Diff Er; Tensión Fuente [V]; Diferencia [V]
