aleperno/labotpfinal/images/div.pdf

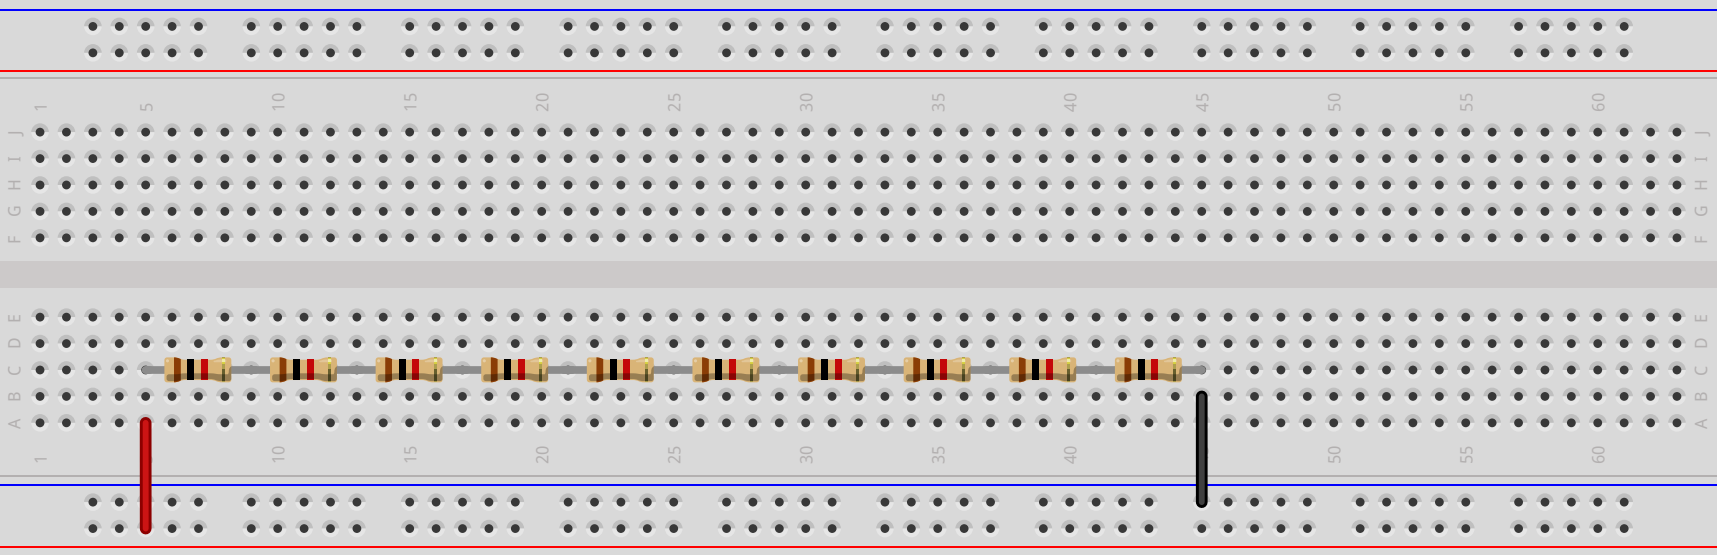
[picture p47: page 1]
