aleperno/labotpfinal/images/labo1_bb.pdf

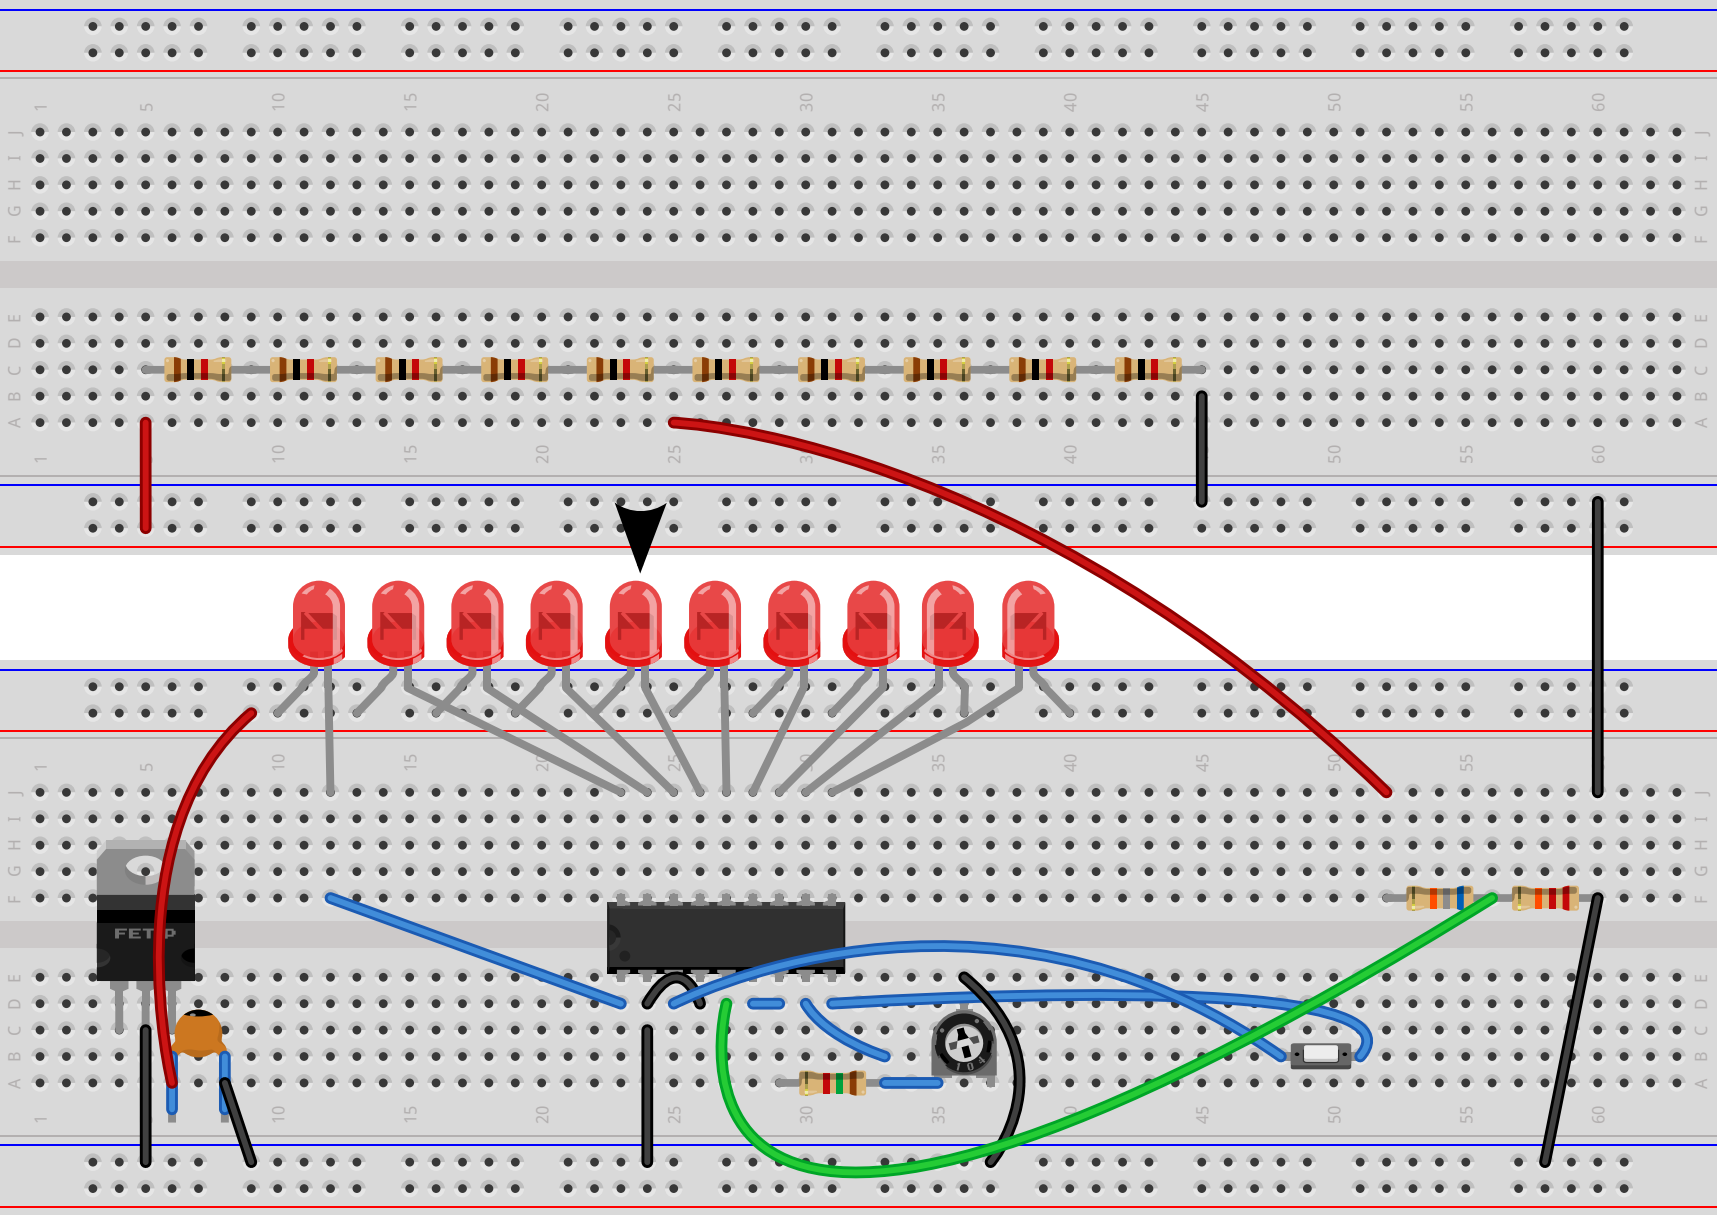
[picture p48: page 1]
