aleperno/labotpfinal/images/labo1_bb1.pdf

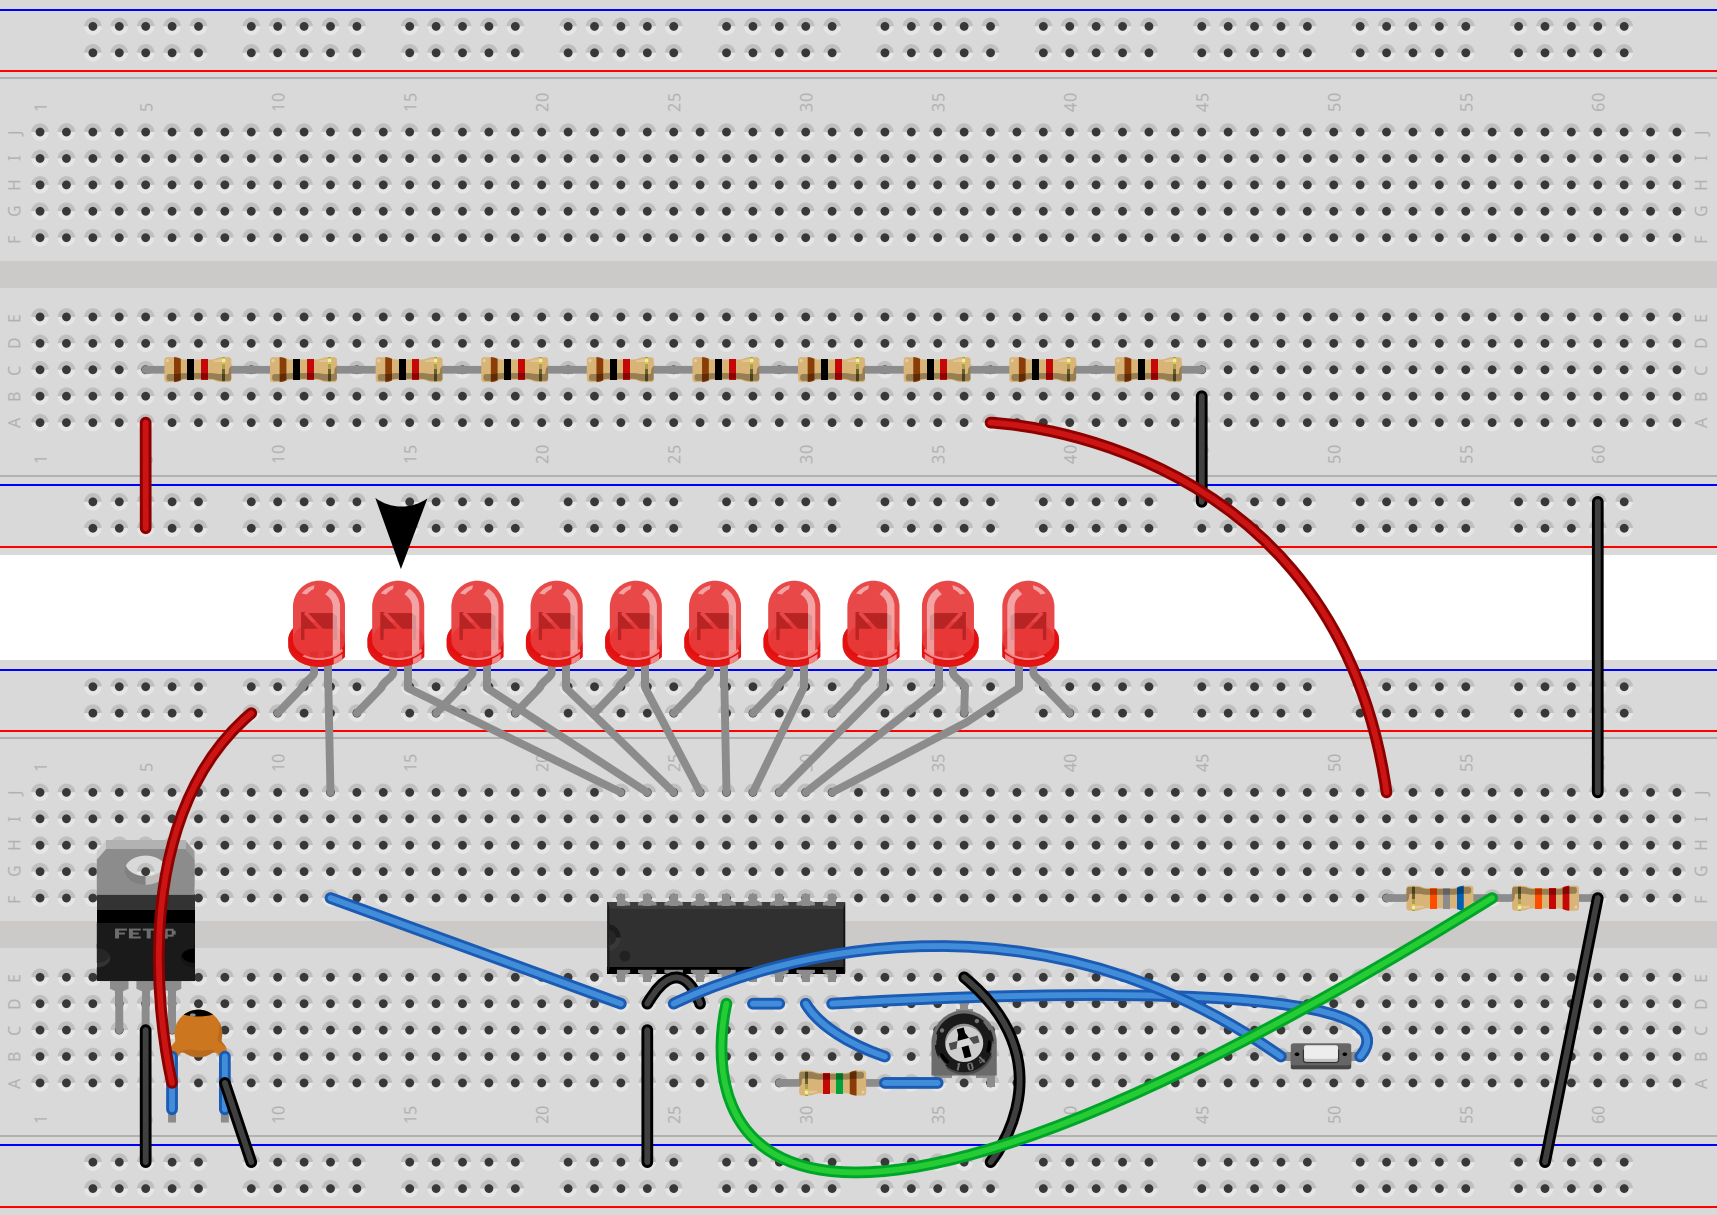
[picture p49: page 1]
