aleperno/labotpfinal/images/labo1_bb2.pdf

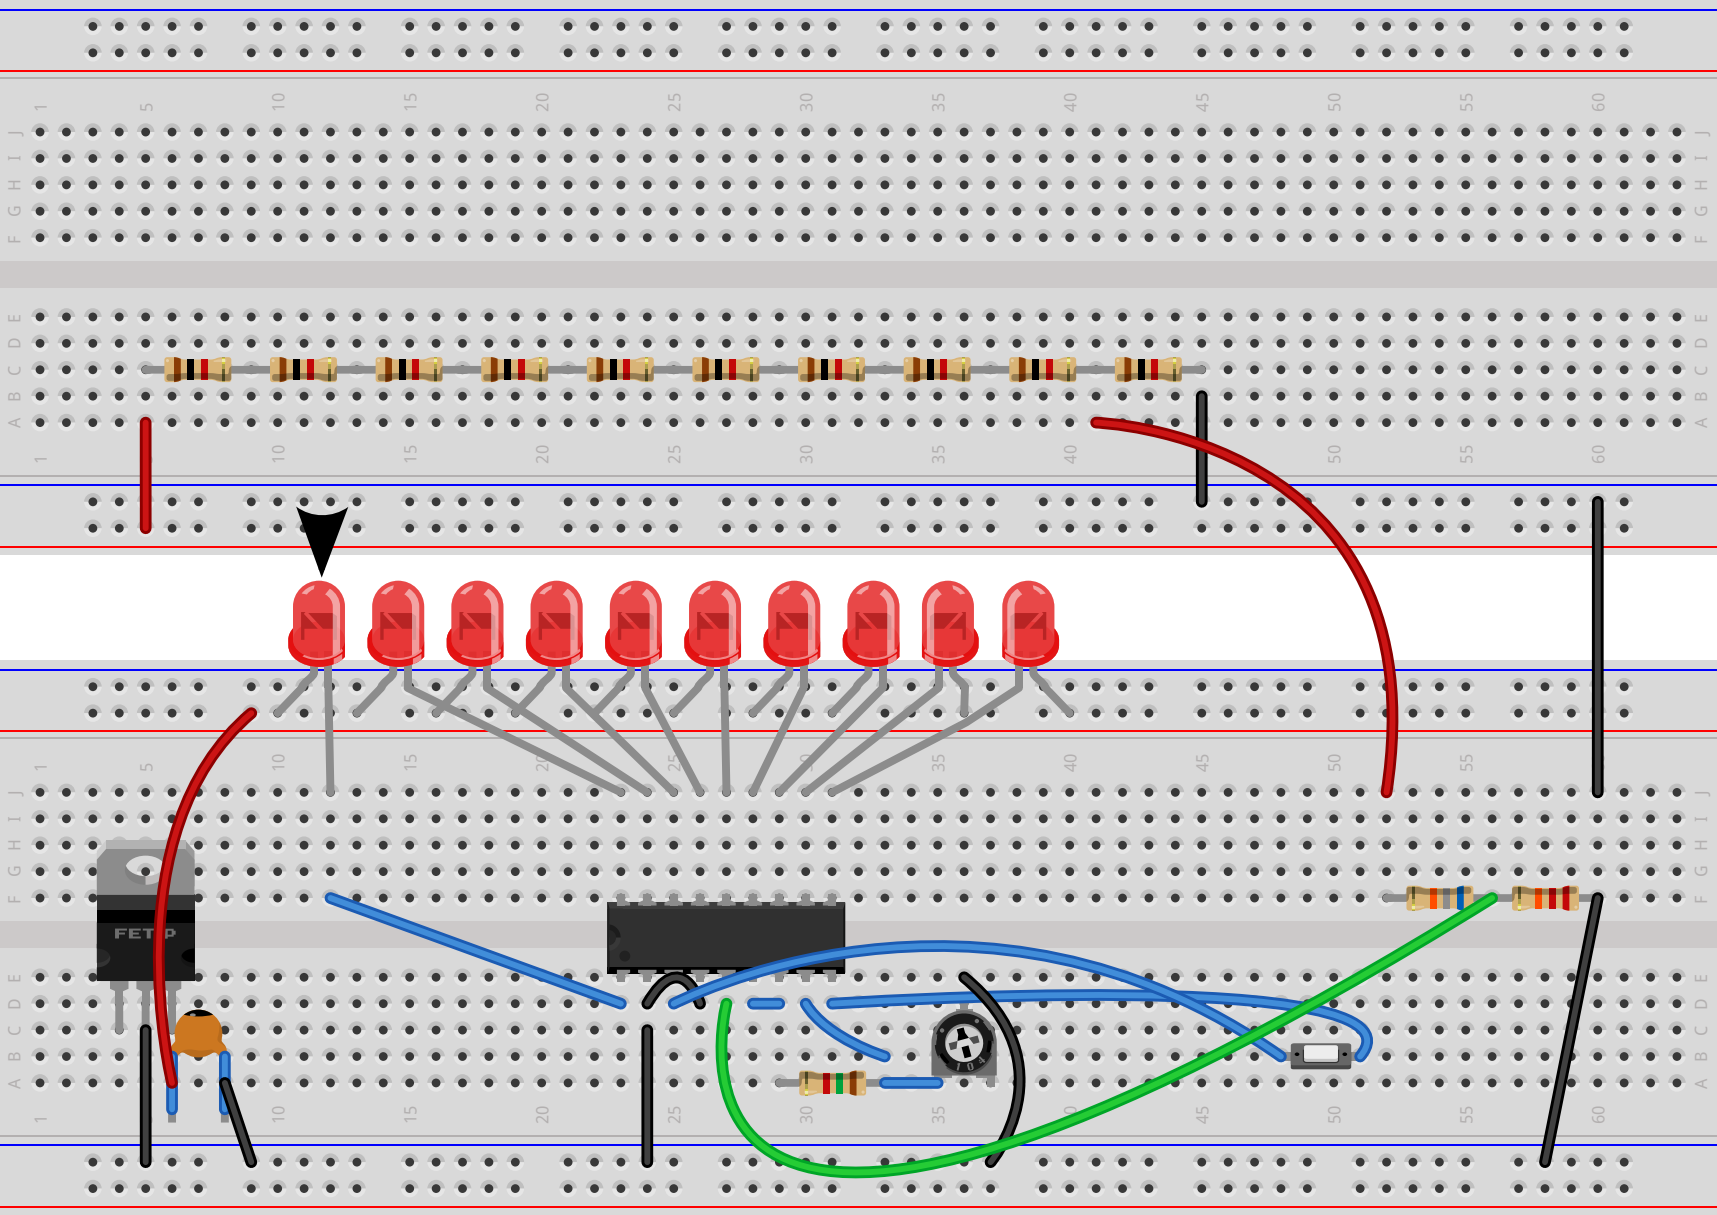
[picture p50: page 1]
