aleperno/labotpfinal/images/labo1_bb3.pdf

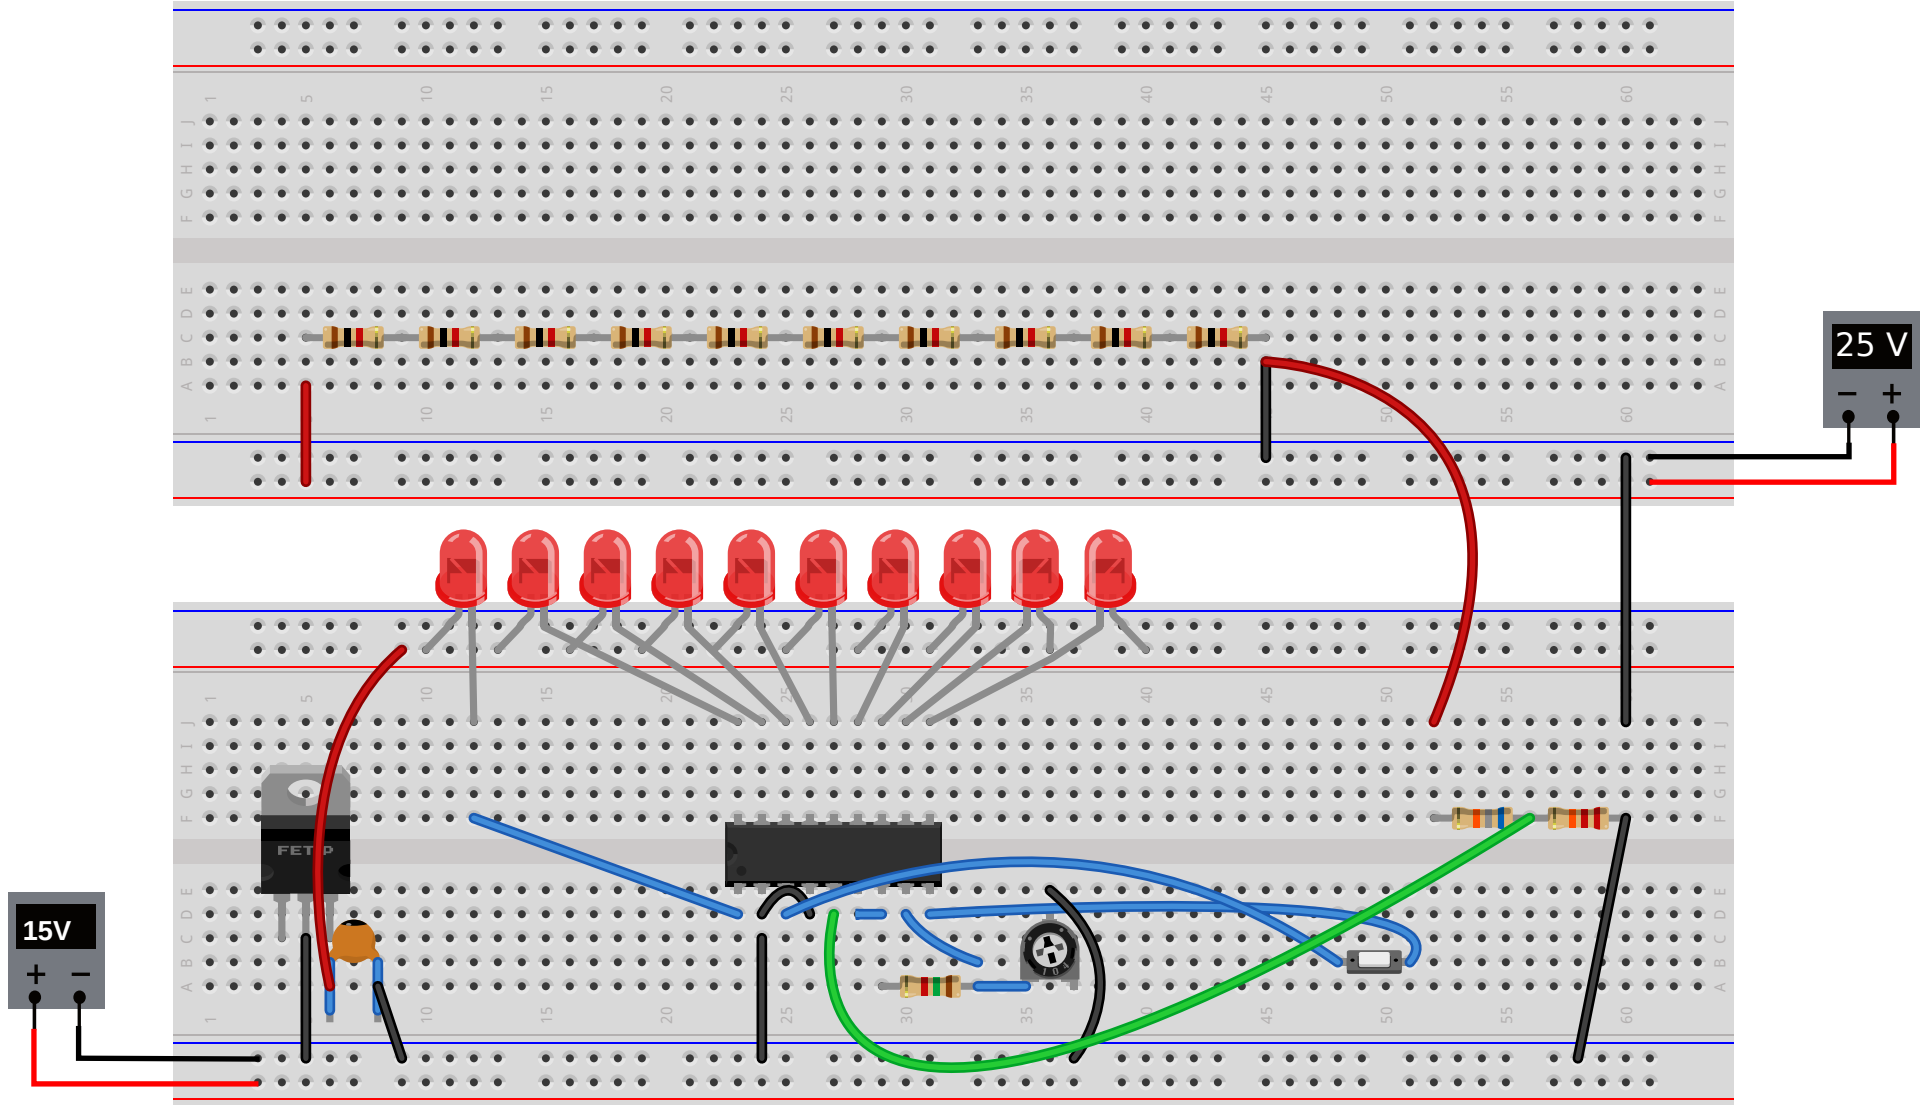
[picture p51: page 1]
