aleperno/labotpfinal/images/banco1.pdf

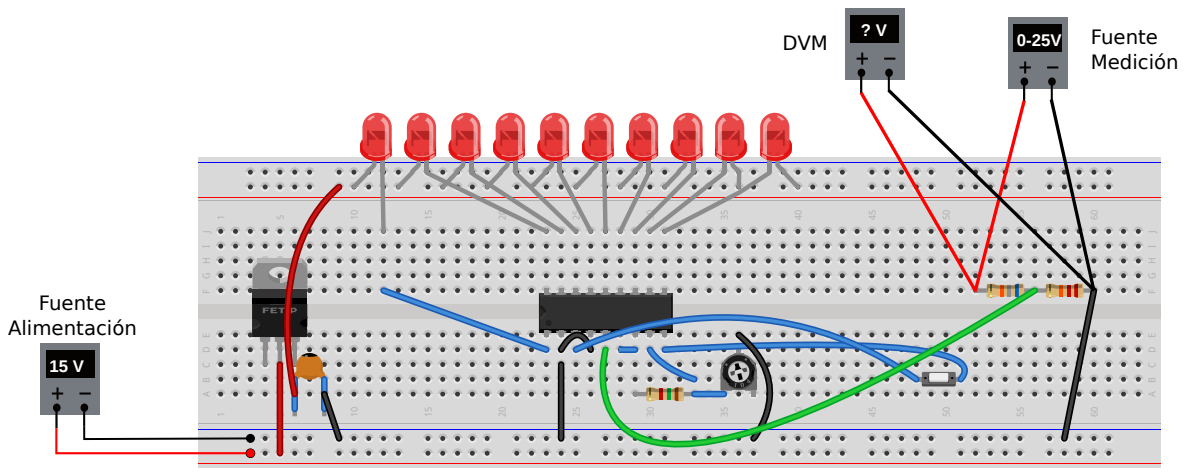
[picture p52: page 1]
Fuente Alimentación; Fuente; Medición; ? V DVM
