aleperno/labotpfinal/images/labo1_bb0.pdf

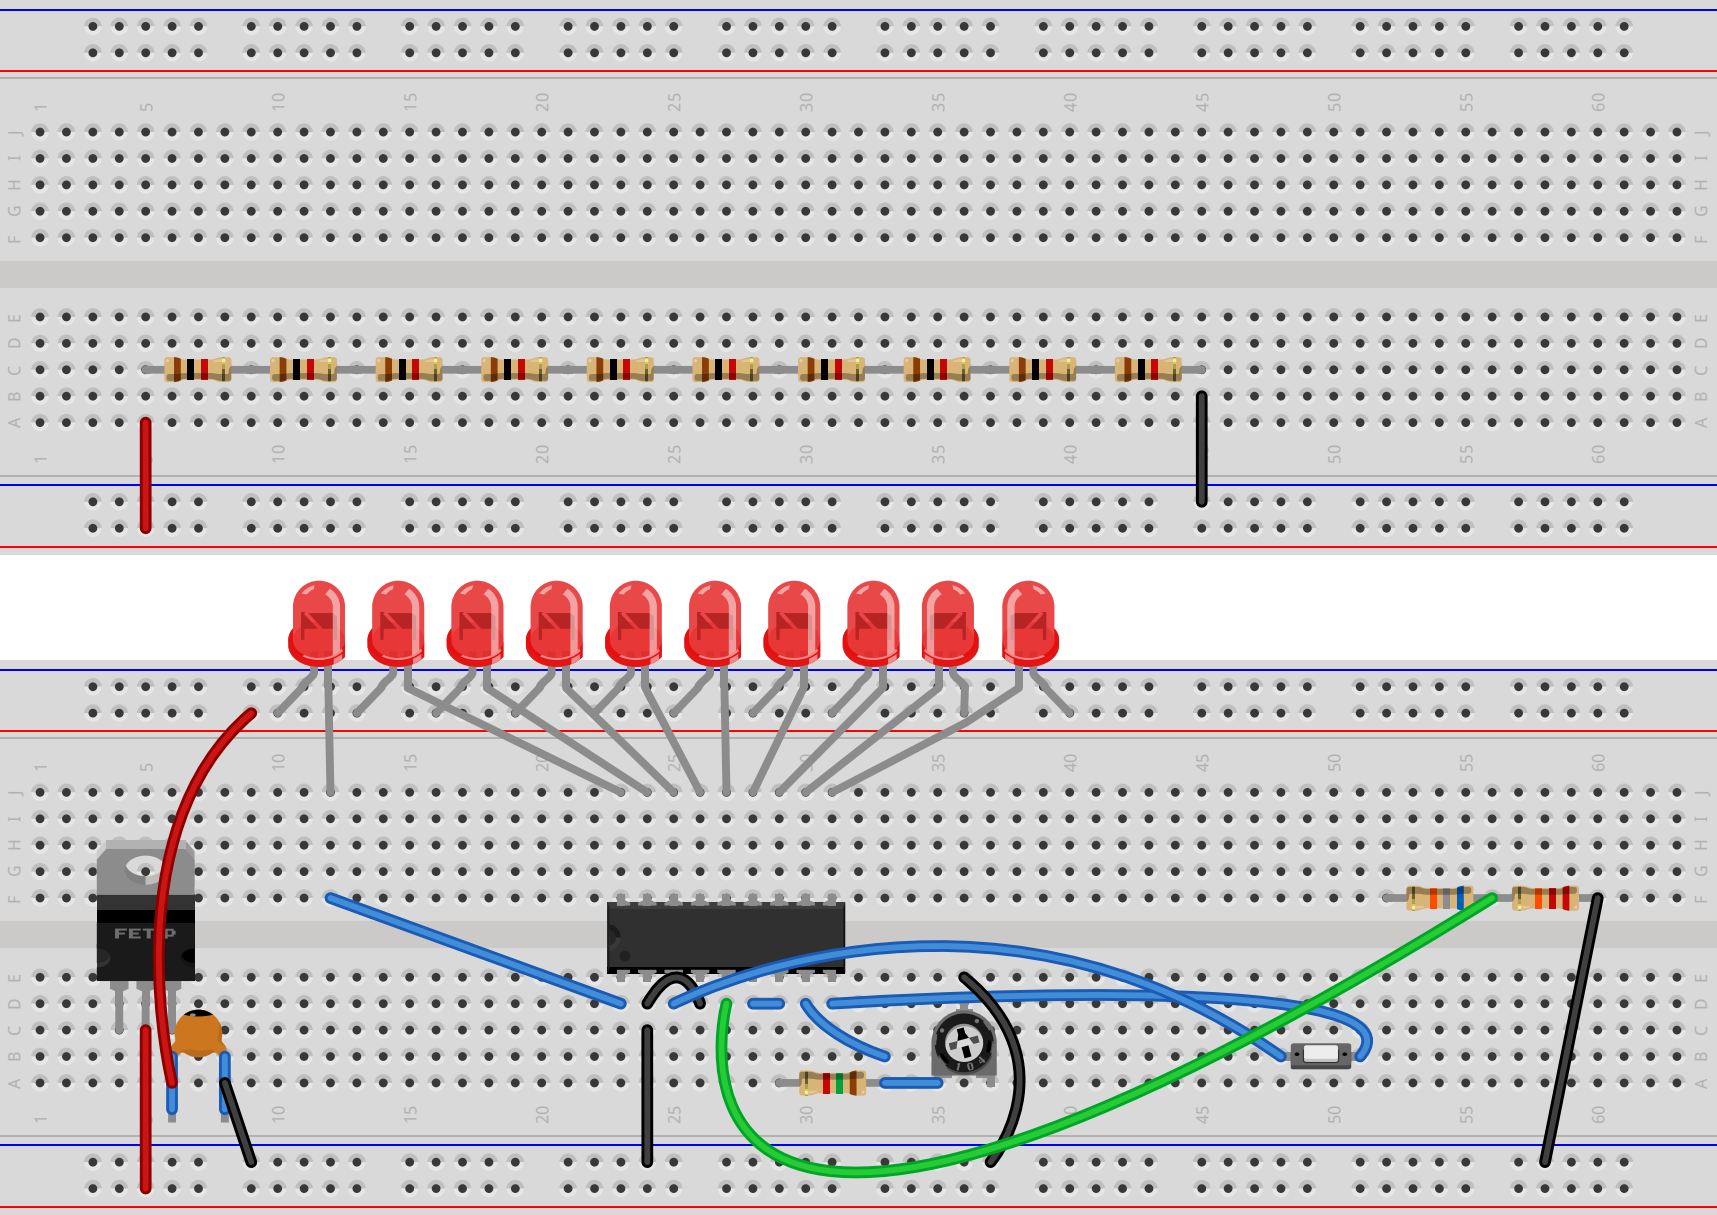
[picture p53: page 1]
