aleperno/labotpfinal/images/proto.pdf

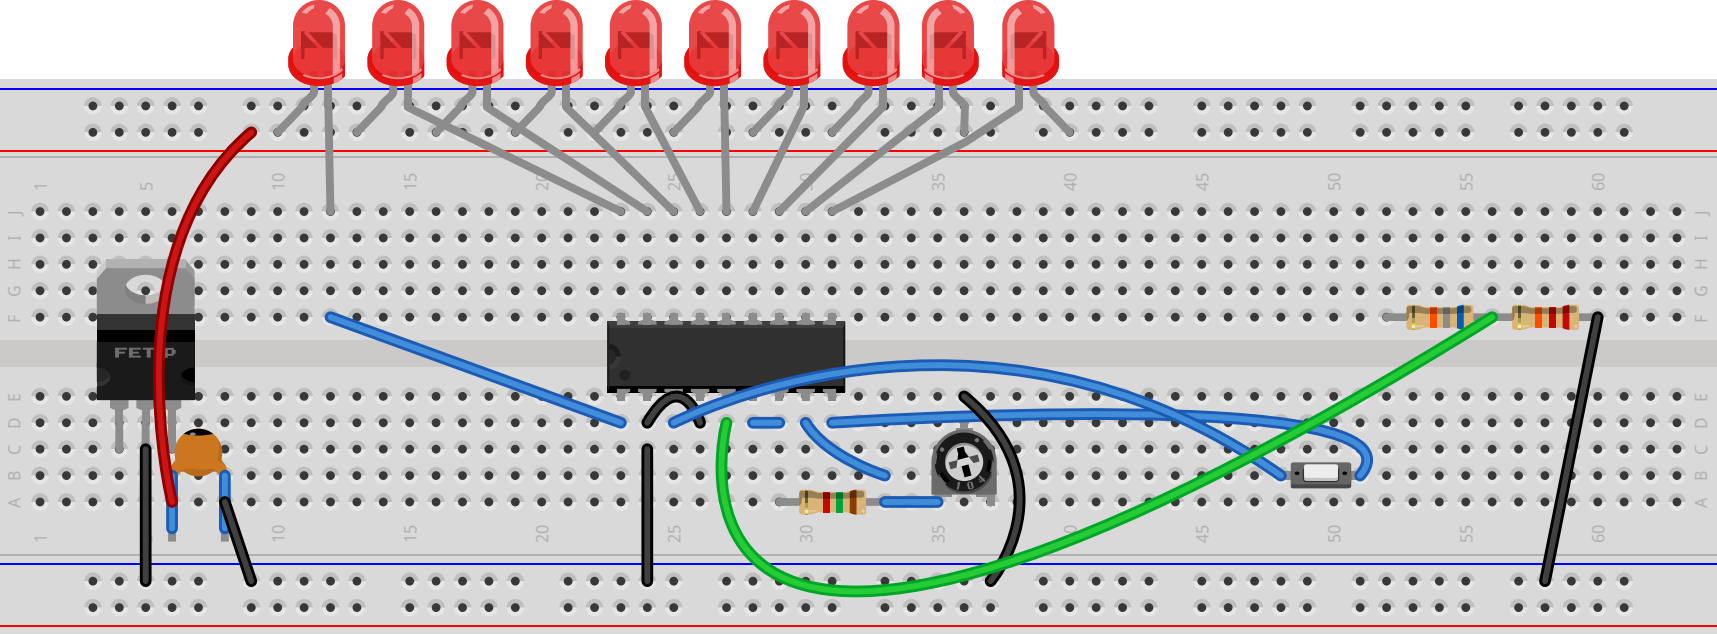
[picture p54: page 1]
