aleperno/labotpfinal/images/labo_bb.pdf

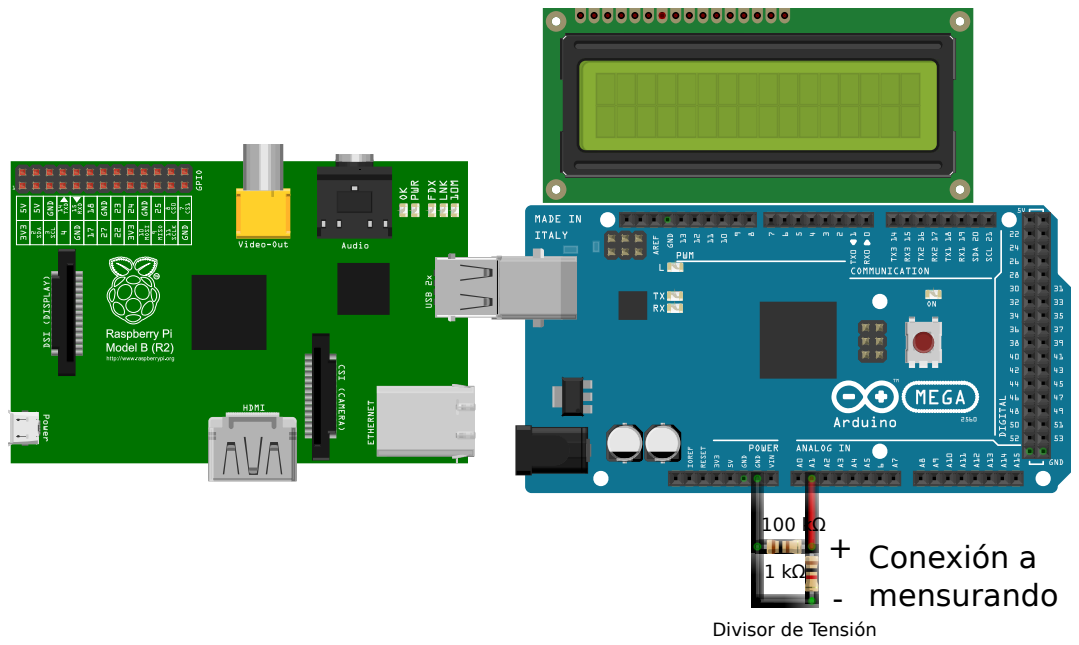
[picture p55: page 1]
Conexión a mensurando

Divisor de Tensión
