aleperno/labotpfinal/attachments/caratula.pdf

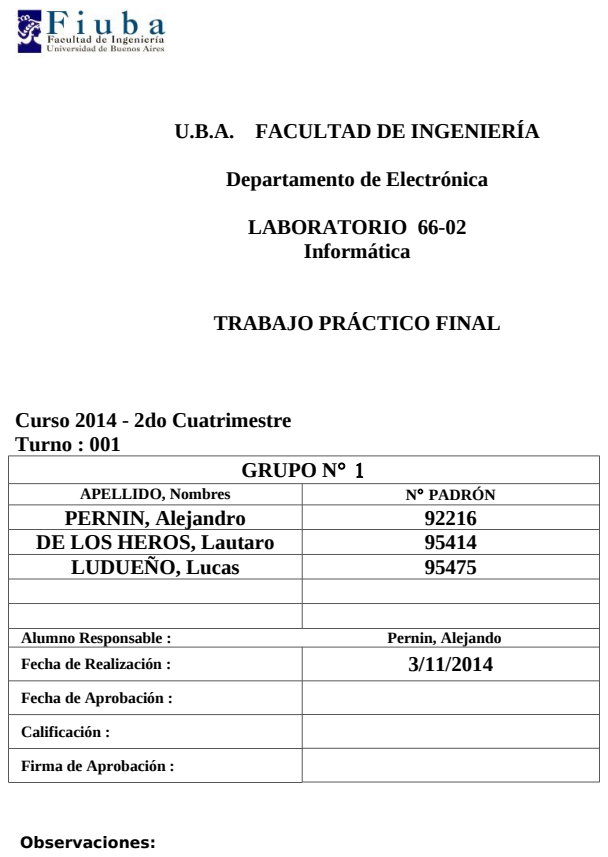
[picture p56: page 1]
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

U.B.A. FACULTAD DE INGENIERÍA

Departamento de Electrónica

TRABAJO PRÁCTICO FINAL

Fecha de Aprobación :

Firma de Aprobación :
