aleperno/labotpfinal/data/labo.sch

## KiCad design data/labo.sch (2014-11-03)

Schematic: labo.sch

Parts:
C1: 0.01 uF
D1, D2, D3, D4, D5, D6, D7, D8, D9, D10: LED
P1: DIL18
P+1: CONN_1
P-1: CONN_1
R1: 1.5k
R2: 5.1 K
R3: 68 K
R4: 22 k
SW1: SW_PUSH
U1: LM7812
V+1: CONN_1
V-1: CONN_1
