aleperno/labotpfinal/(commit log)

2014-11-03 Agregado pdf de cekit
2014-11-03 agrego esquematico
    [labo.sch]
2014-11-14 Inicio lista de precios
2014-11-14 Agregado tabla mediciones
    [tabla.ods]
2015-01-07 Summer Mods
    [tabla.ods]
2015-01-07 Ordenado en carpetas
    [labo.sch, log.ods, tabla.ods]
